mhechavarria/color-caps-classifier/programa motores/IMG_20181013_155259965.jpeg

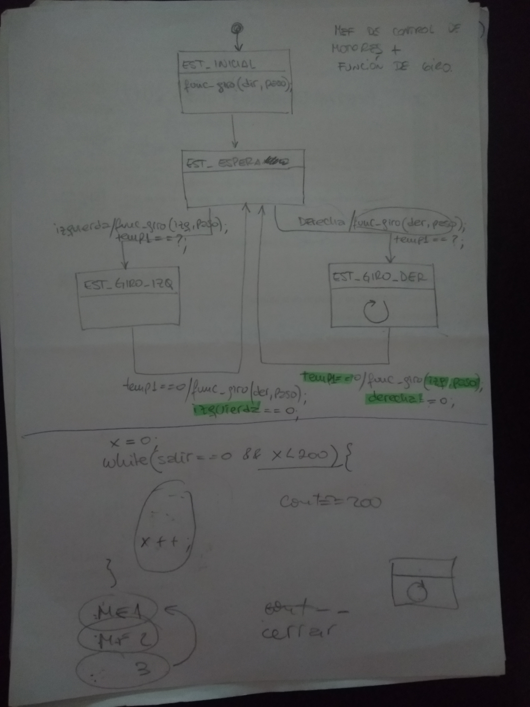
programa motores/IMG_20181013_155259965.jpeg
