mhechavarria/color-caps-classifier/Script/tapa_roja(1).png

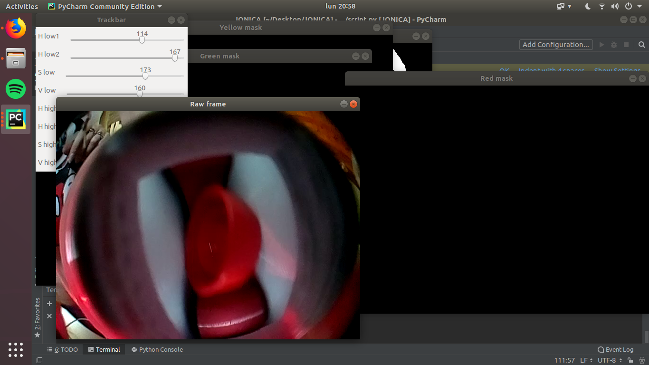
Script/tapa_roja(1).png
