mhechavarria/color-caps-classifier/README.md

# color-caps-classifier
A project made mostly in python to classifie color caps using OpenCV and Python

Link to video: https://drive.google.com/open?id=1r29vyWqCW7NpwiLaEyCusYoAQh5E9Sr1
