mhechavarria/color-caps-classifier/INFORME/mef_control_motores.png

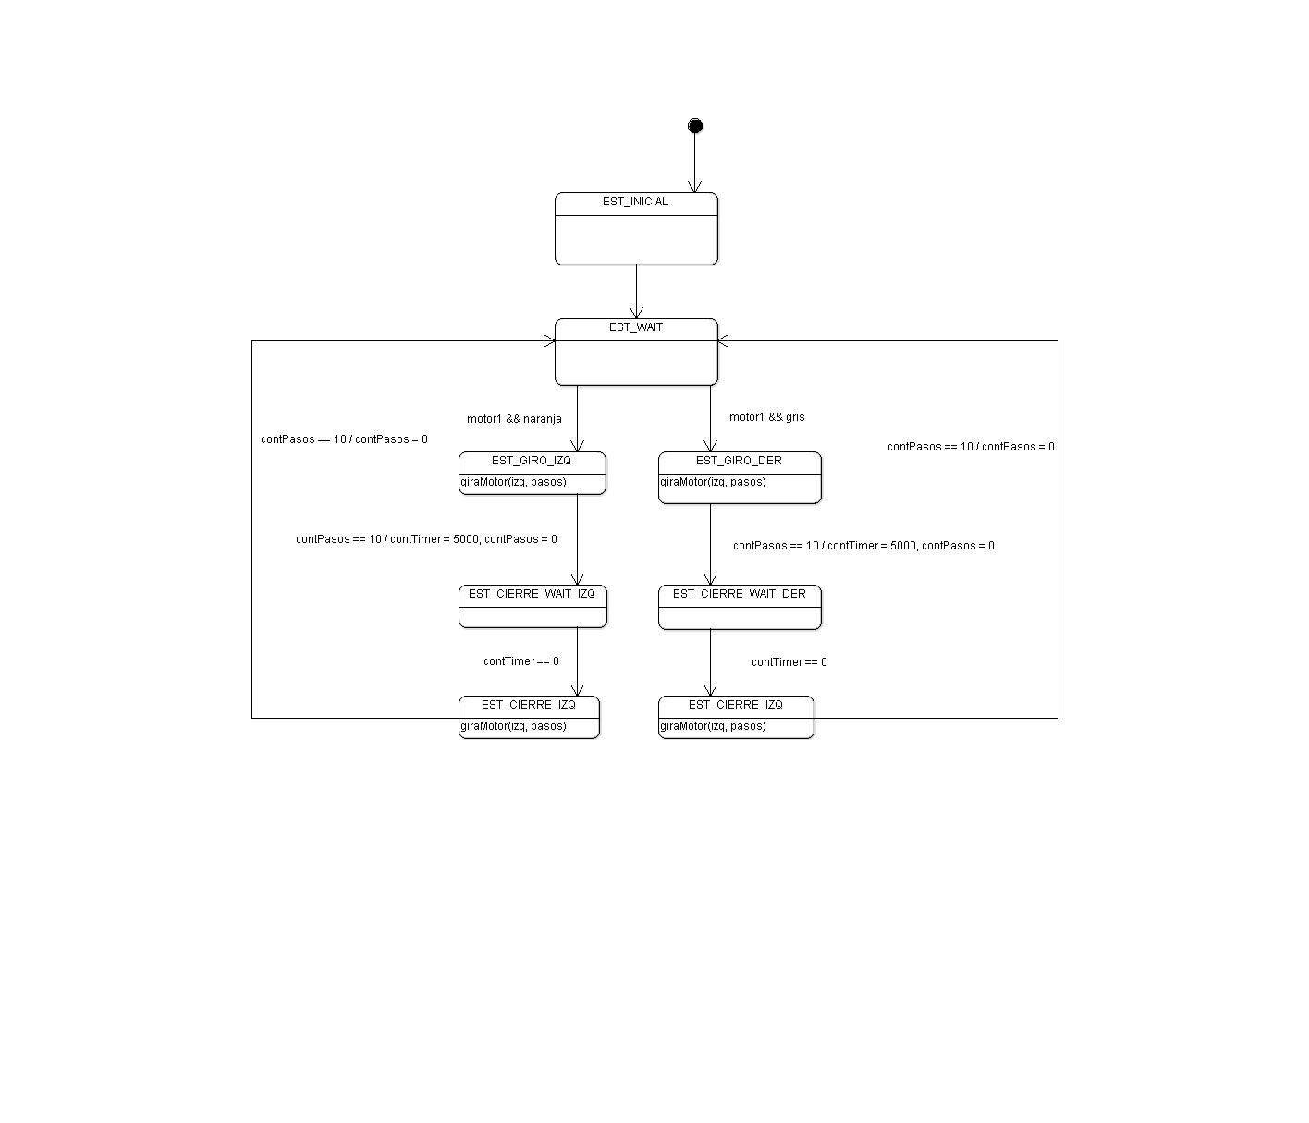
INFORME/mef_control_motores.png
