mhechavarria/color-caps-classifier/JONICA Rasp/Desktop/imagen2.jpg

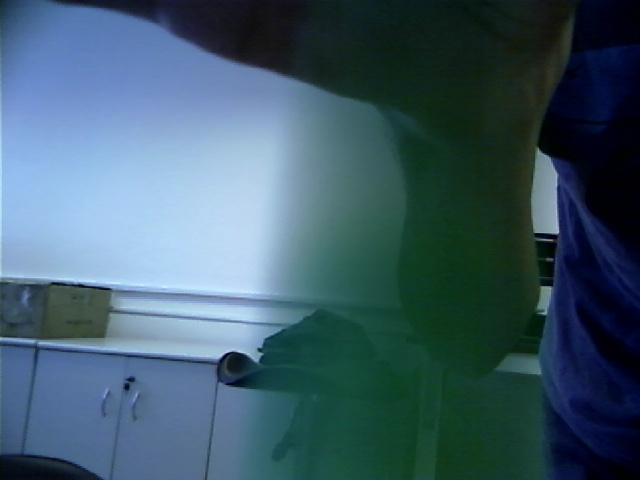
JONICA Rasp/Desktop/imagen2.jpg
