mhechavarria/color-caps-classifier/JONICA Rasp/WhatsApp Image 2019-03-05 at 5.52.41 PM.jpeg

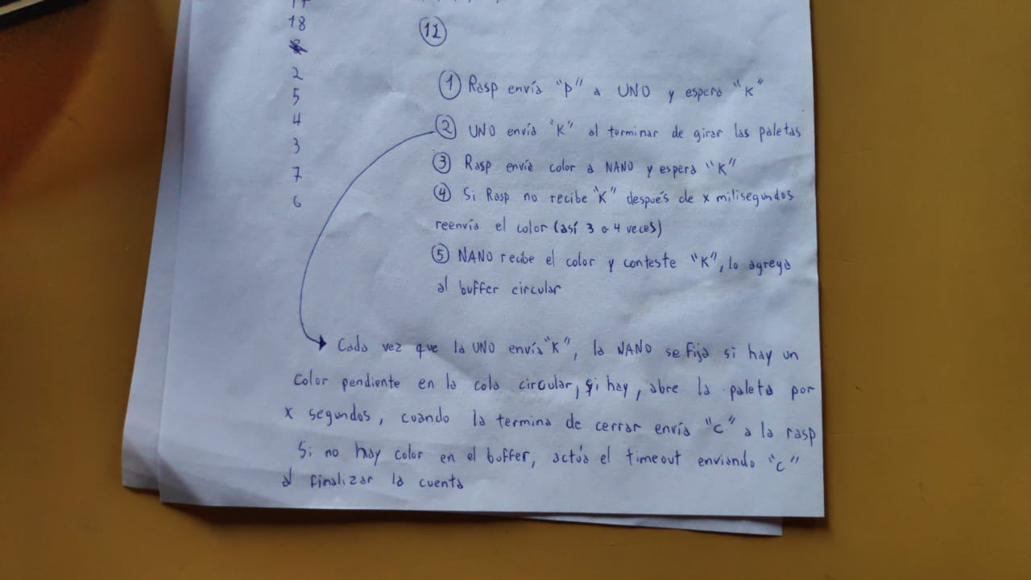
JONICA Rasp/WhatsApp Image 2019-03-05 at 5.52.41 PM.jpeg
