mhechavarria/color-caps-classifier/Modelos v4/Tuercas metrica.jpg

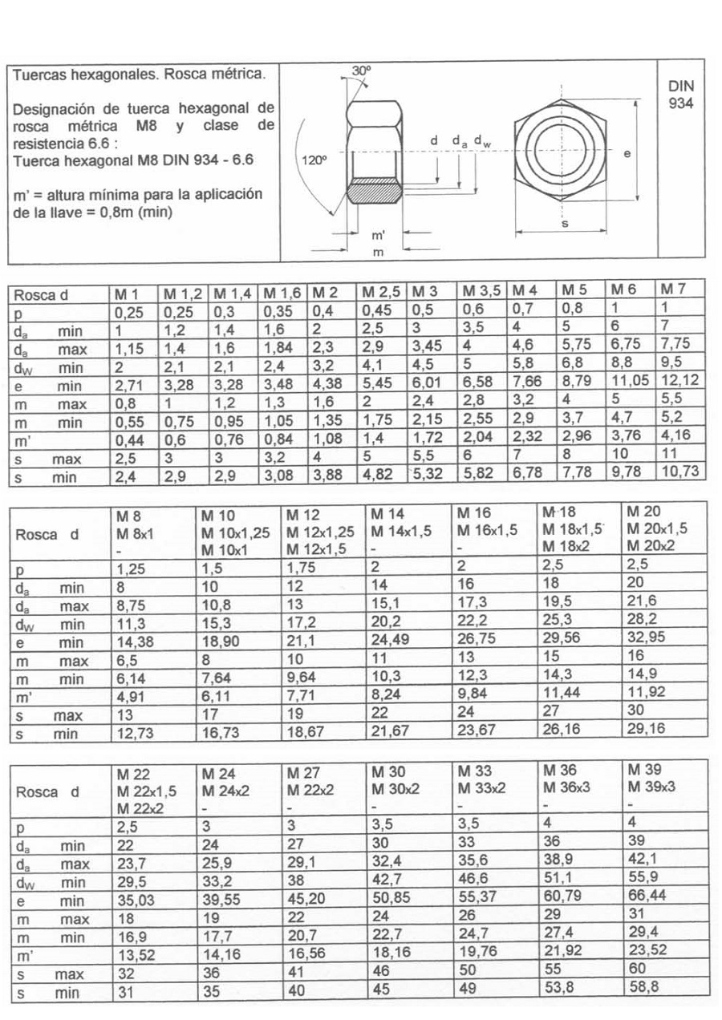
Modelos v4/Tuercas metrica.jpg
