mhechavarria/color-caps-classifier/Motor_paso_a_paso.ino/NEMA 17 sizes.png

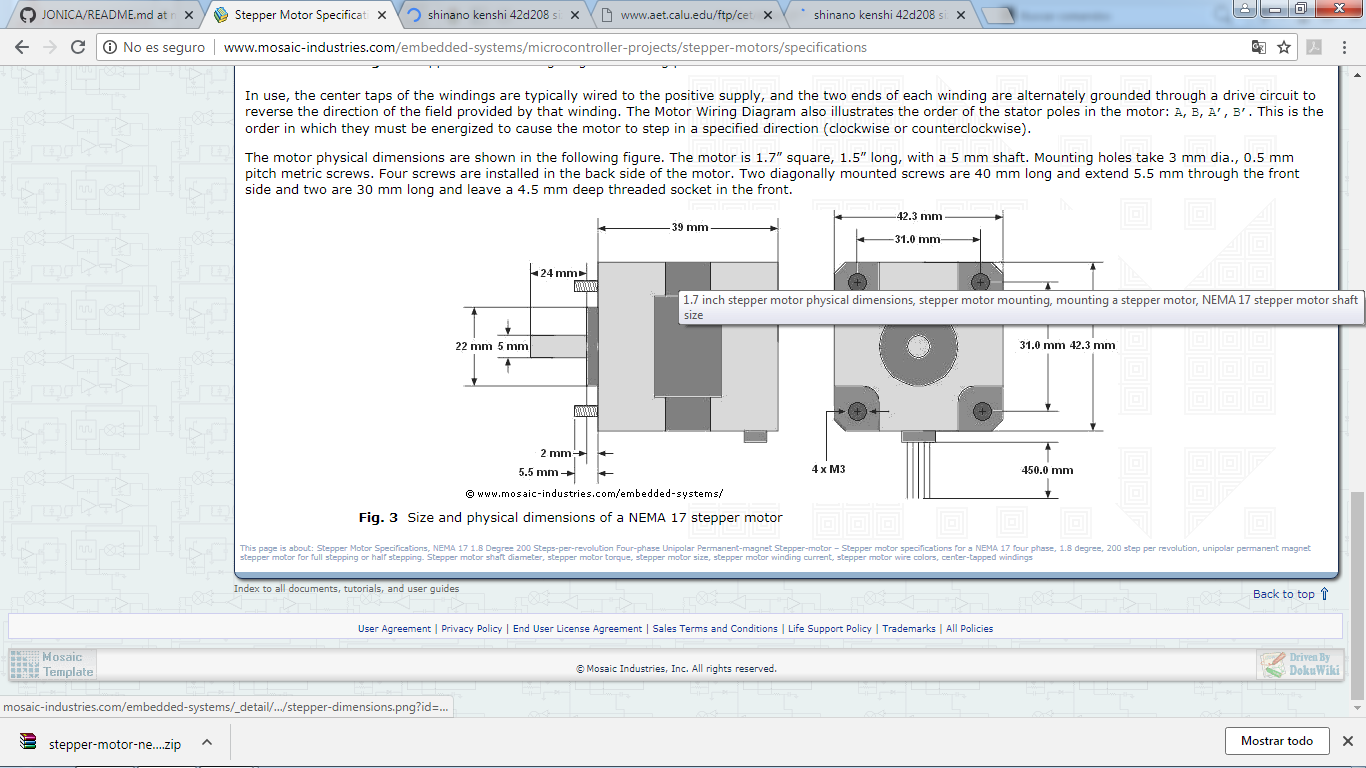
Motor_paso_a_paso.ino/NEMA 17 sizes.png
