mhechavarria/color-caps-classifier/programa motores/IMG_20181013_155317110.jpeg

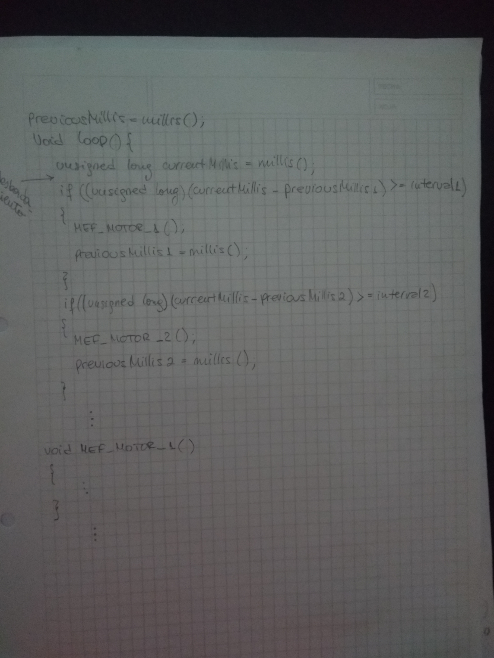
programa motores/IMG_20181013_155317110.jpeg
