mhechavarria/color-caps-classifier/programa motores/IMG_20181013_155327888.jpeg

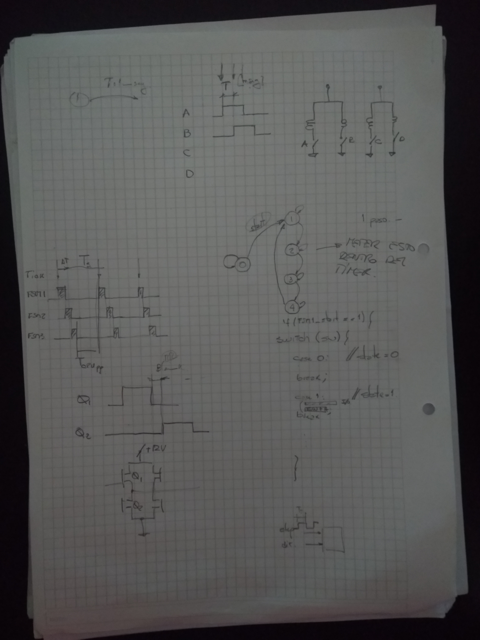
programa motores/IMG_20181013_155327888.jpeg
