mhechavarria/color-caps-classifier/programa motores/IMG_20181013_155341643.jpeg

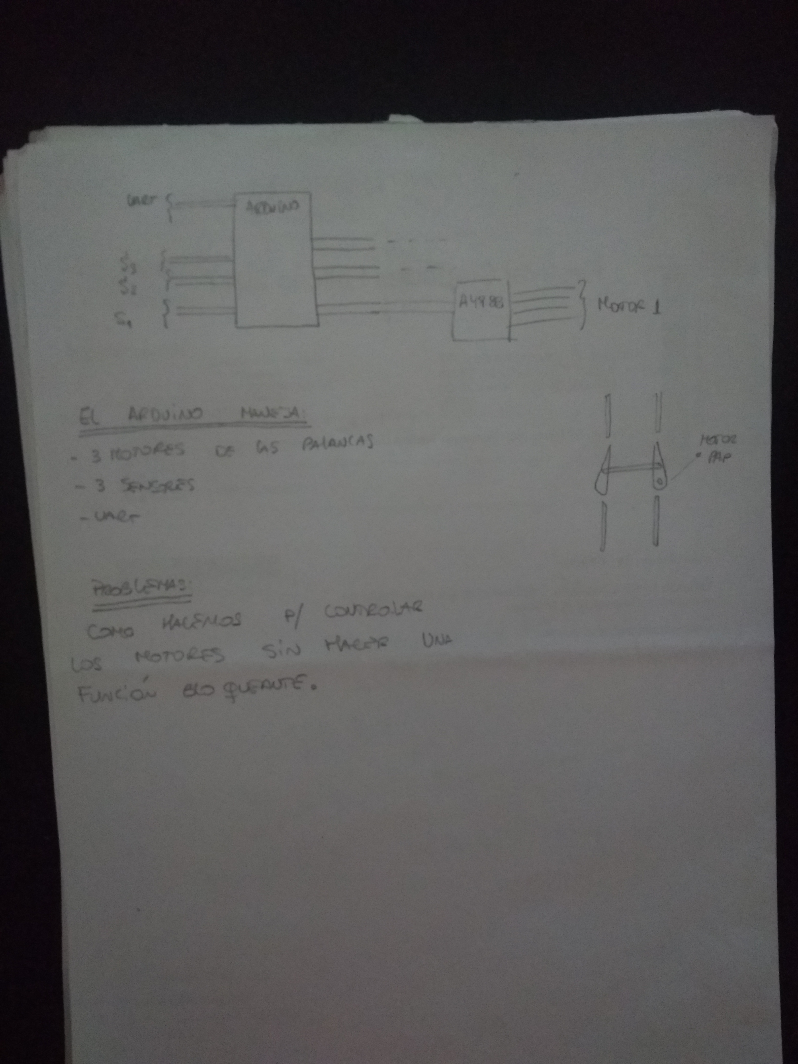
programa motores/IMG_20181013_155341643.jpeg
