mhechavarria/color-caps-classifier/programa motores/IMG_20181013_155406590.jpeg

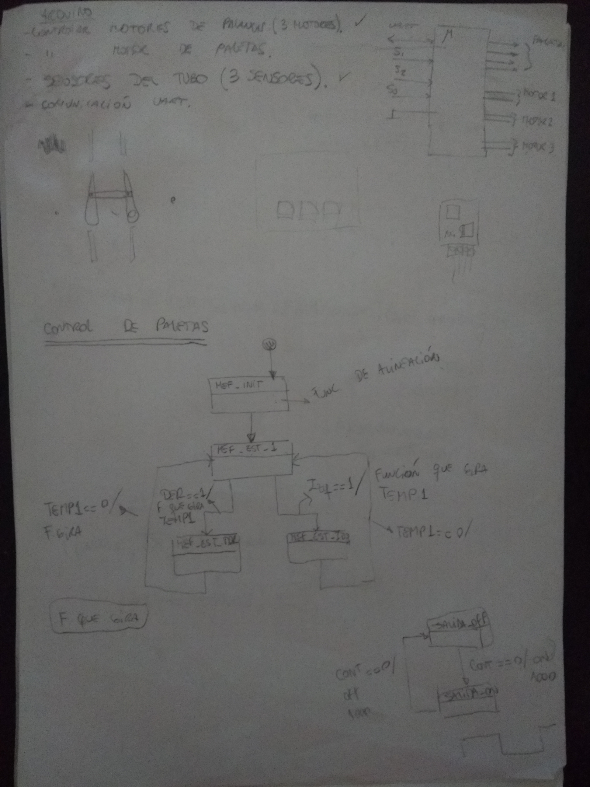
programa motores/IMG_20181013_155406590.jpeg
