mhechavarria/color-caps-classifier/programa motores/IMG_20181013_155413697.jpeg

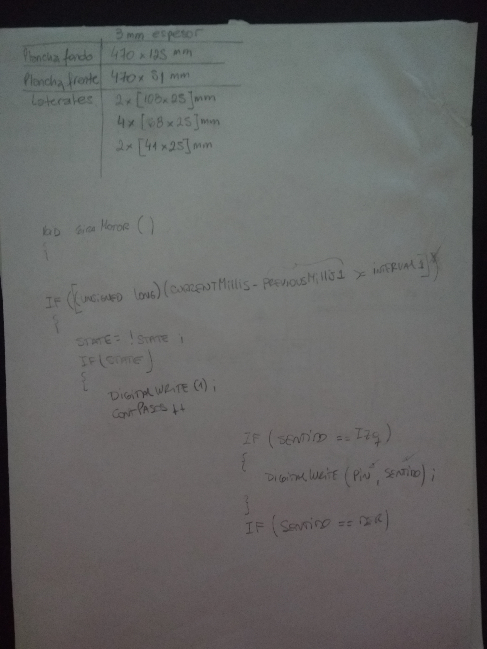
programa motores/IMG_20181013_155413697.jpeg
