mhechavarria/color-caps-classifier/programa motores/IMG_20190116_182555074.jpg

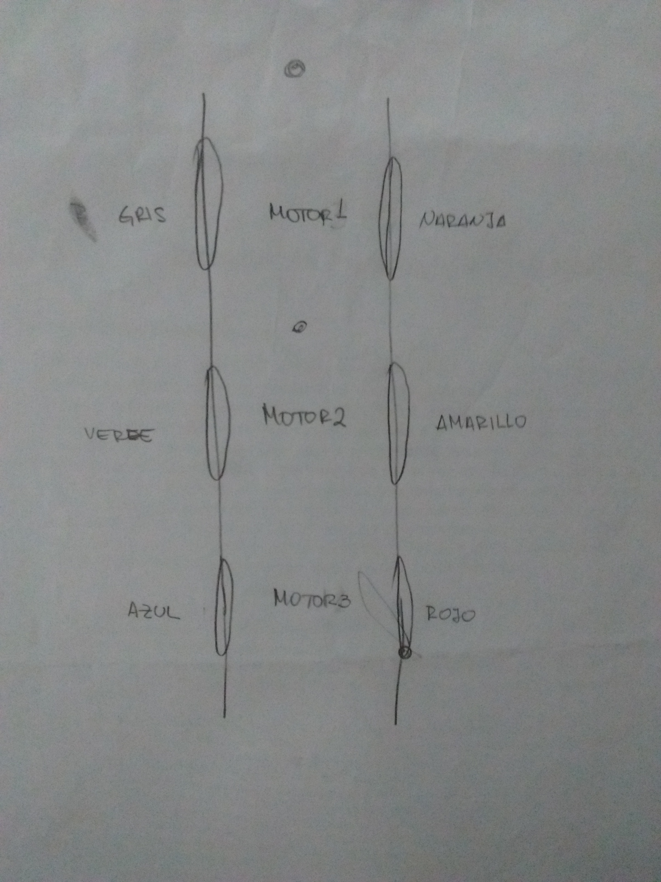
programa motores/IMG_20190116_182555074.jpg
