mhechavarria/color-caps-classifier/Script/tapa_verde(1).png

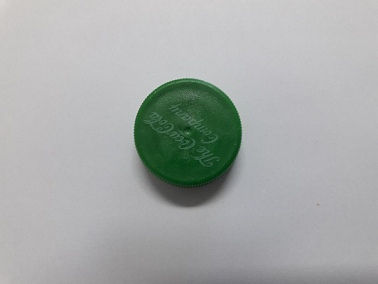
Script/tapa_verde(1).png
