mhechavarria/color-caps-classifier/Modelos v4/Ensamblaje.SLDASM

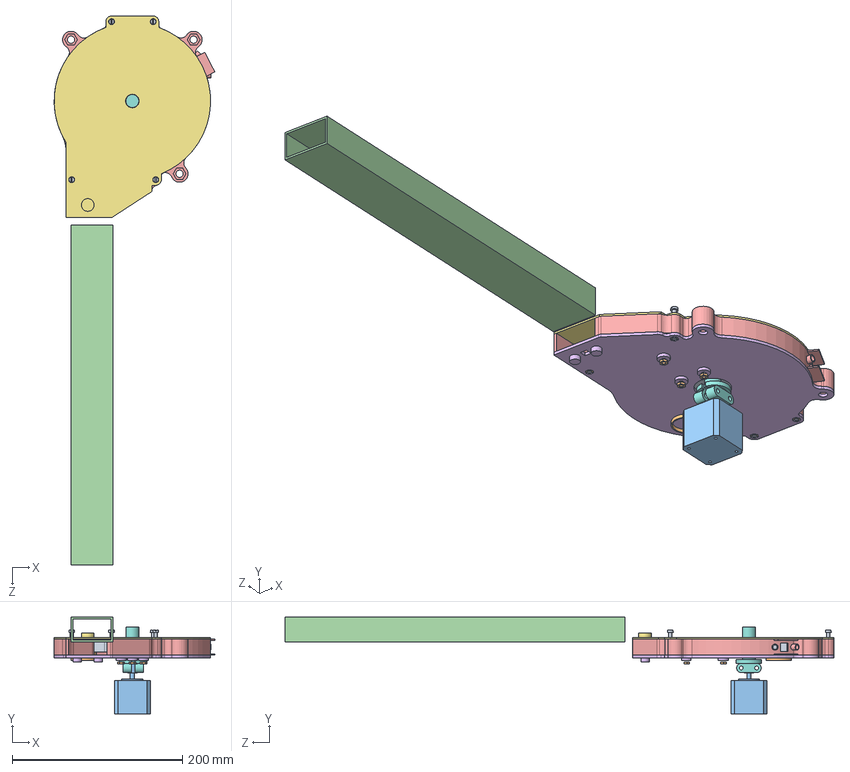
[picture p22: CAD file, 2019-12-16]
Modelos v4/Ensamblaje.SLDASM
189.0 x 113.8 x 645.7 mm
Prototipo
Tapa Coca Cola amarilla
Motor NEMA 17
Cargador
Curvas paletas
Tapa atras paletas
Tapa frente paletas
Acople NEMA 17 v2
slotted cheese head screw_din x 4
hex thin nut gradeb_din x 7
