mhechavarria/color-caps-classifier/Modelos v4/Palanquitas/Ensamblaje.SLDASM

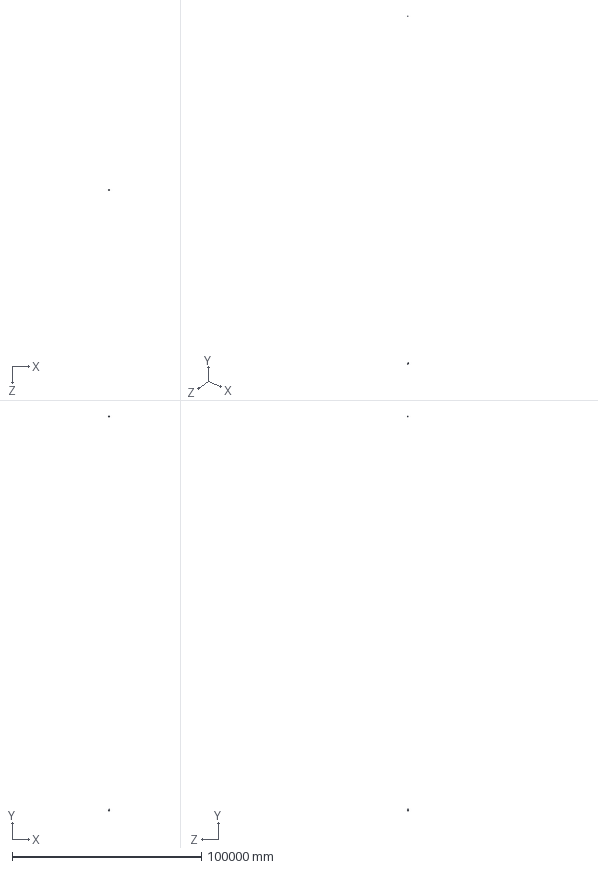
[picture p23: CAD file, 2019-12-16]
Modelos v4/Palanquitas/Ensamblaje.SLDASM
101.2 x 208279.6 x 134.6 mm
Palanquitas
SimetríaPalanquitas
Tapones x 2
