mhechavarria/color-caps-classifier/Modelos v4/Palanquitas/Tubo salida con palancas.SLDASM

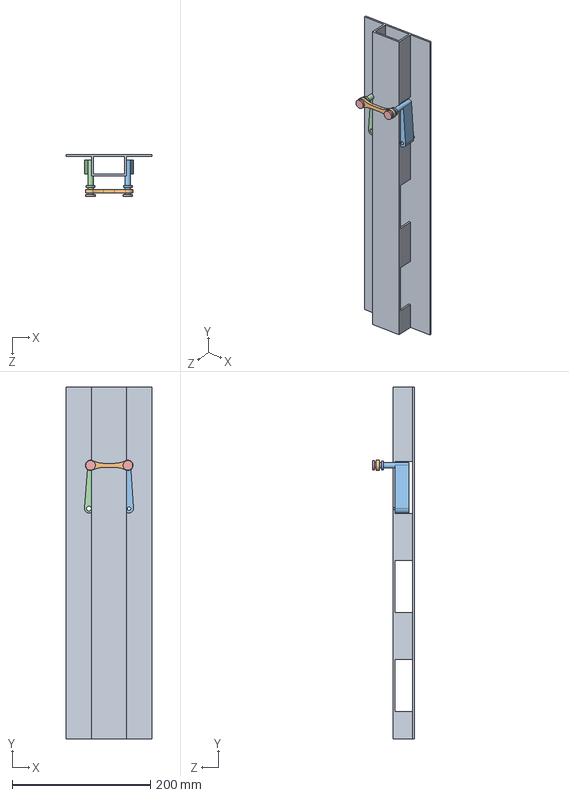
[picture p24: CAD file, 2019-12-16]
Modelos v4/Palanquitas/Tubo salida con palancas.SLDASM
125.0 x 509.0 x 61.0 mm
Tubo de salida
Palanquita der
Palanquita izq
Tapones x 2
