mhechavarria/color-caps-classifier/Modelos v4/Paredes paletas.SLDASM

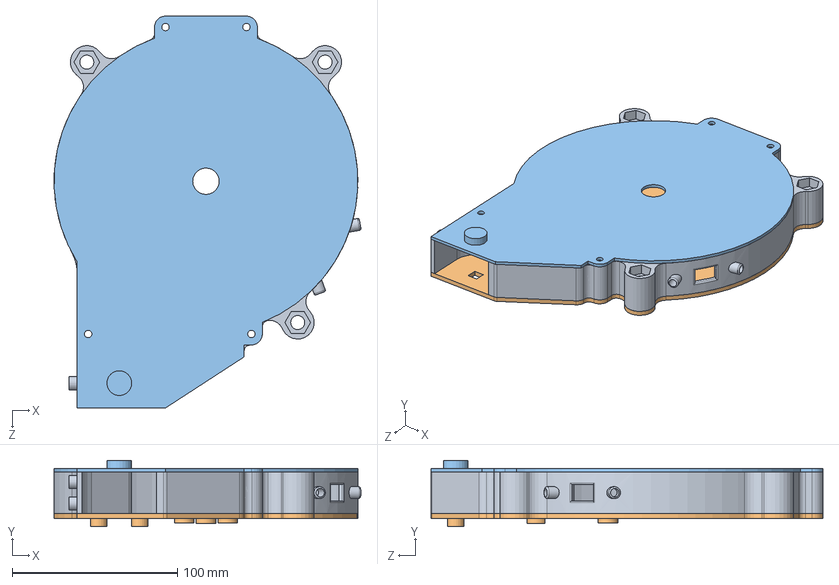
[picture p25: CAD file, 2019-12-16]
Modelos v4/Paredes paletas.SLDASM
185.9 x 40.0 x 237.2 mm
Curvas paletas
Tapa atras paletas
Tapa frente paletas
