mhechavarria/color-caps-classifier/Caño para seleccionar tapas/Palanquita2.SLDPRT

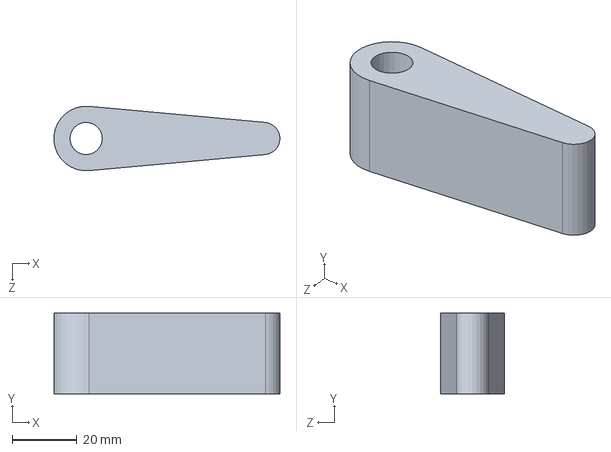
[picture p26: CAD file, 2019-12-16]
Caño para seleccionar tapas/Palanquita2.SLDPRT
70.0 x 25.0 x 19.9 mm
