mhechavarria/color-caps-classifier/Modelos v4/Case Raspberry/Base.SLDPRT

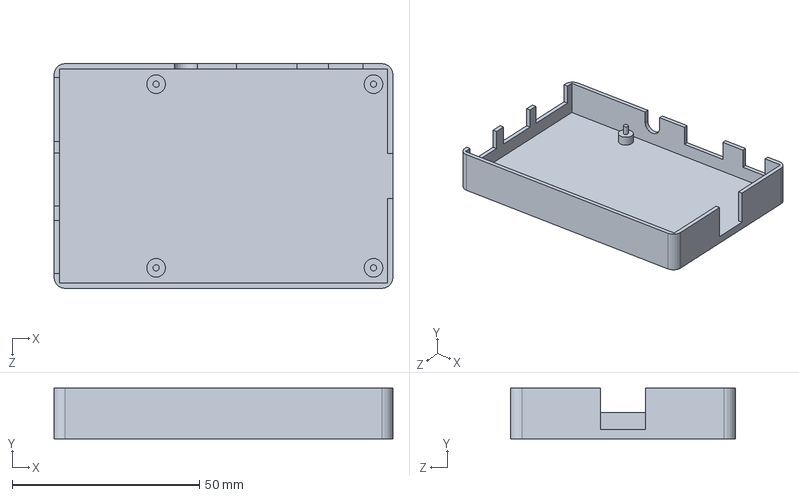
[picture p27: CAD file, 2019-12-16]
Modelos v4/Case Raspberry/Base.SLDPRT
90.4 x 13.6 x 60.0 mm
