mhechavarria/color-caps-classifier/Modelos v4/Palanquitas/Tapones.SLDPRT

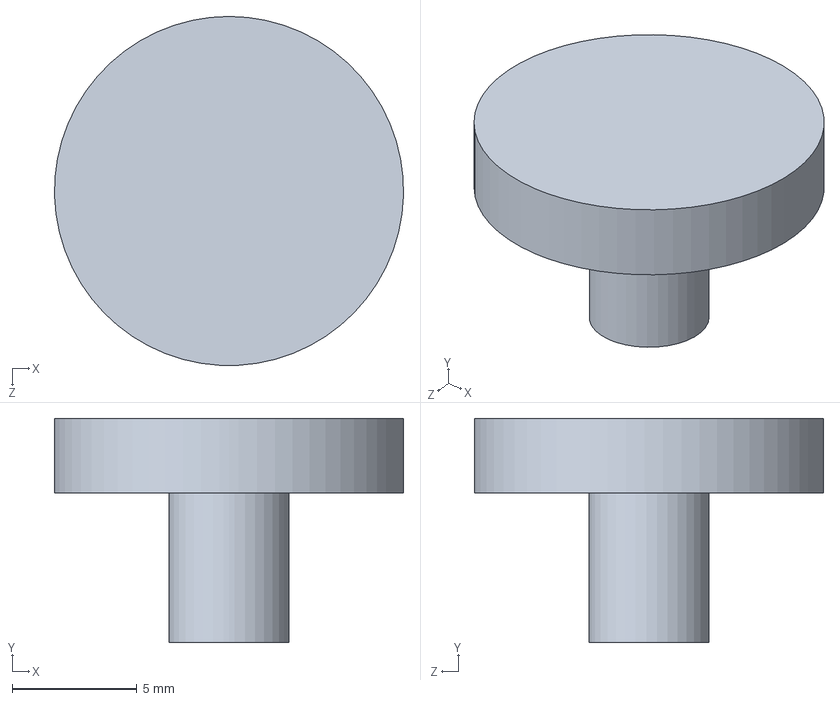
[picture p28: CAD file, 2019-12-16]
Modelos v4/Palanquitas/Tapones.SLDPRT
14.0 x 9.00 x 14.0 mm
