mhechavarria/color-caps-classifier/Modelos v4/Paredes paleta 1 (2).SLDPRT

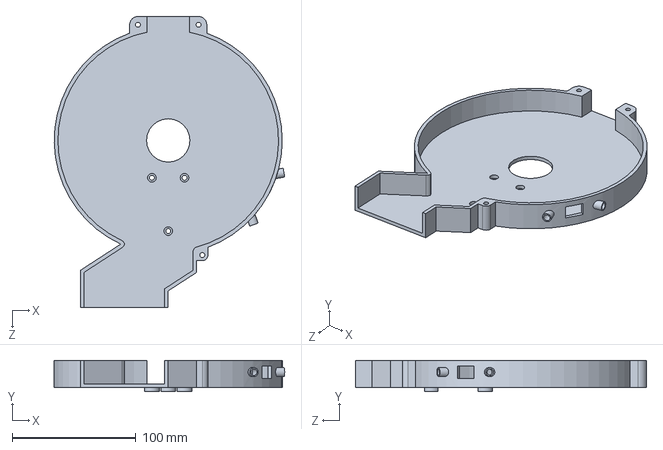
[picture p29: CAD file, 2019-12-16]
Modelos v4/Paredes paleta 1 (2).SLDPRT
186.0 x 25.3 x 234.8 mm
