mhechavarria/color-caps-classifier/Modelos v4/STL/Curvas paletas/Curva 1.STL

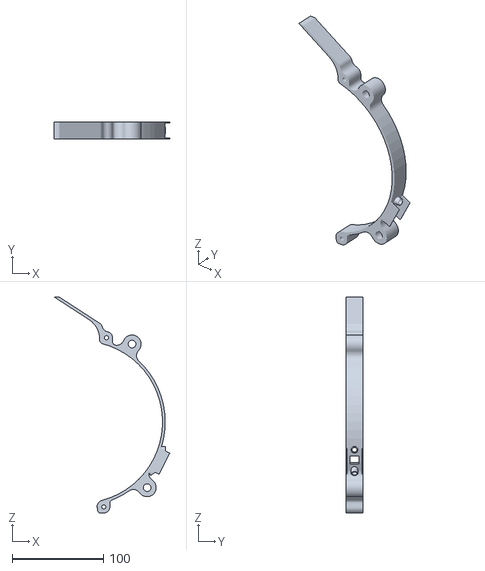
[picture p30: CAD file, 2019-12-16]
Modelos v4/STL/Curvas paletas/Curva 1.STL
127.0 x 19.0 x 237.2
