mhechavarria/color-caps-classifier/Caño para seleccionar tapas/Part1.SLDPRT

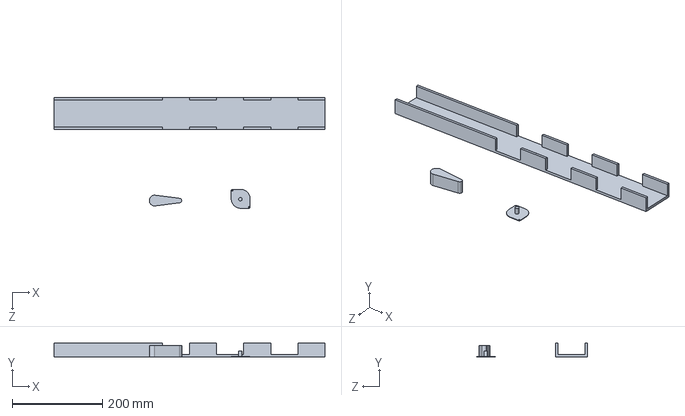
[picture p31: CAD file, 2019-12-16]
Caño para seleccionar tapas/Part1.SLDPRT
600.0 x 30.0 x 244.9 mm
