mhechavarria/color-caps-classifier/Modelos v4/Case Raspberry/Top.SLDPRT

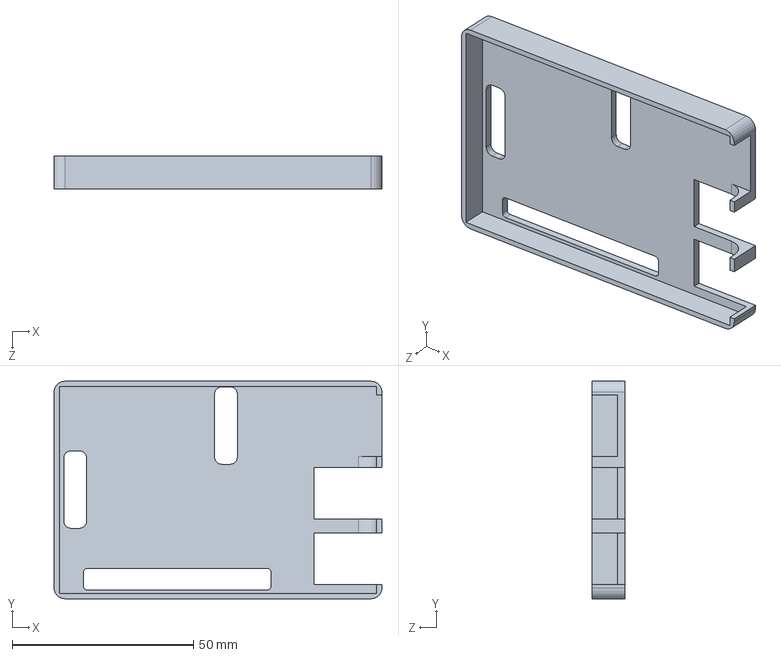
[picture p32: CAD file, 2019-12-16]
Modelos v4/Case Raspberry/Top.SLDPRT
90.4 x 60.0 x 9.00 mm
