mhechavarria/color-caps-classifier/Modelos v4/Motor NEMA 17.SLDPRT

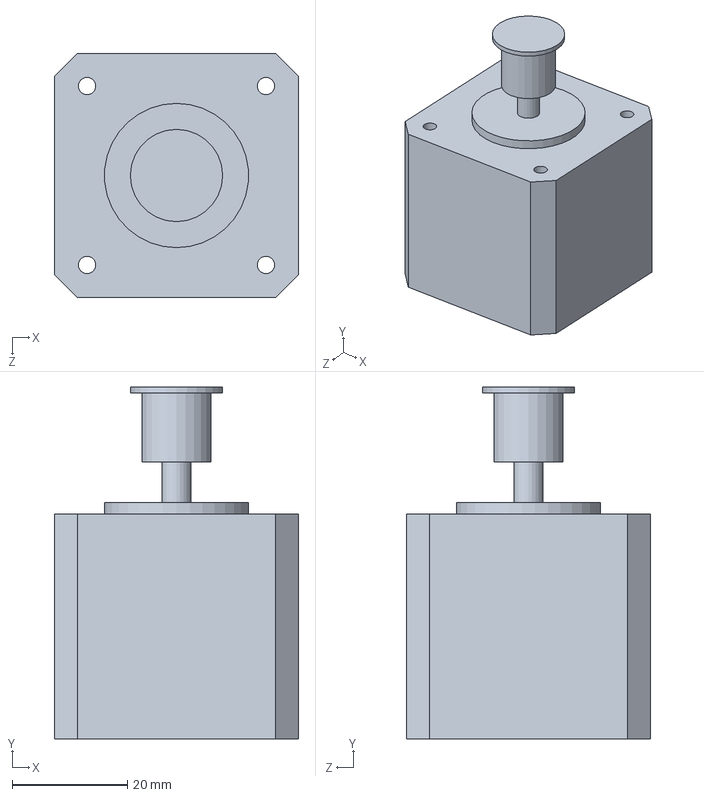
[picture p33: CAD file, 2019-12-16]
Modelos v4/Motor NEMA 17.SLDPRT
42.3 x 61.0 x 42.3 mm
