mhechavarria/color-caps-classifier/Modelos v4/STL/Curvas paletas/Curva 2.STL

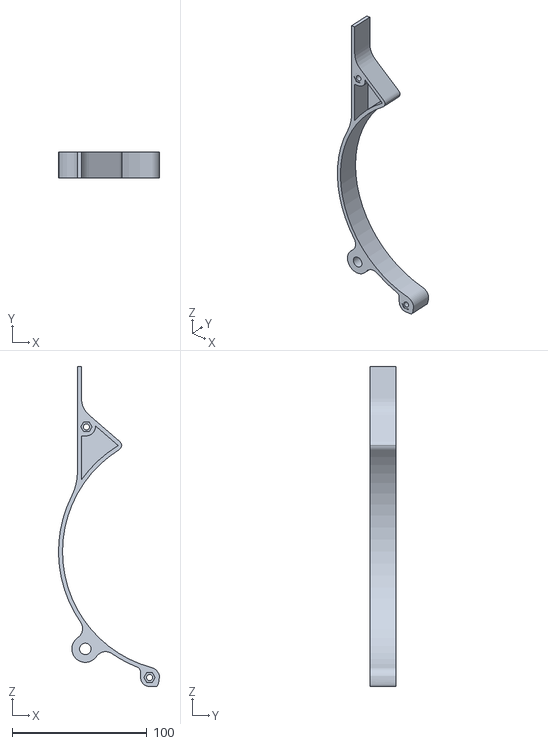
[picture p34: CAD file, 2019-12-16]
Modelos v4/STL/Curvas paletas/Curva 2.STL
74.8 x 19.0 x 237.2
