mhechavarria/color-caps-classifier/Caño para seleccionar tapas/Caño selector.SLDPRT

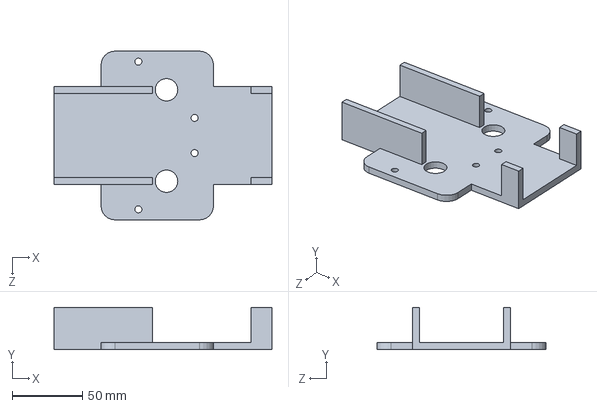
[picture p35: CAD file, 2019-12-16]
Caño para seleccionar tapas/Caño selector.SLDPRT
155.0 x 30.0 x 120.0 mm
