mhechavarria/color-caps-classifier/Modelos v4/Palanquitas/Palanquitas.SLDPRT

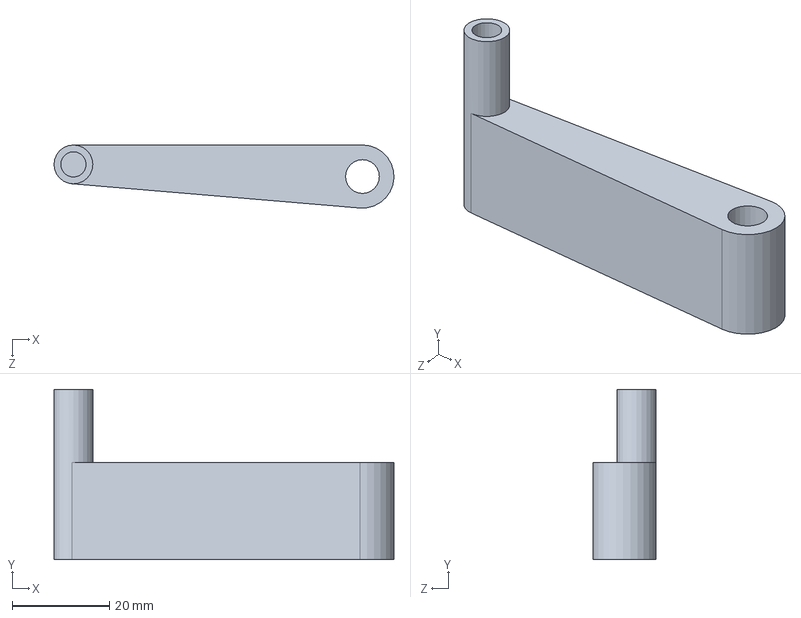
[picture p36: CAD file, 2019-12-16]
Modelos v4/Palanquitas/Palanquitas.SLDPRT
70.0 x 35.0 x 13.0 mm
