mhechavarria/color-caps-classifier/Modelos v4/Prototipo.SLDPRT

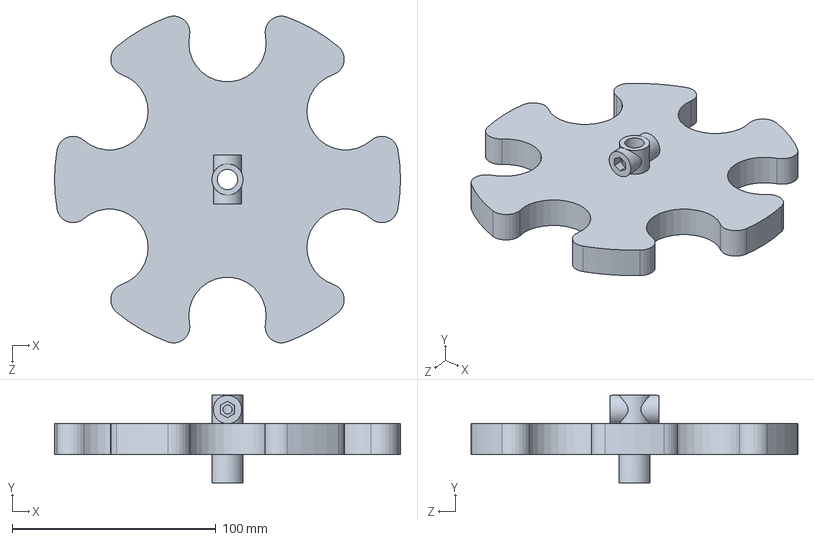
[picture p37: CAD file, 2019-12-16]
Modelos v4/Prototipo.SLDPRT
170.0 x 43.0 x 160.5 mm
