mhechavarria/color-caps-classifier/Modelos v4/Acople NEMA 17.SLDPRT

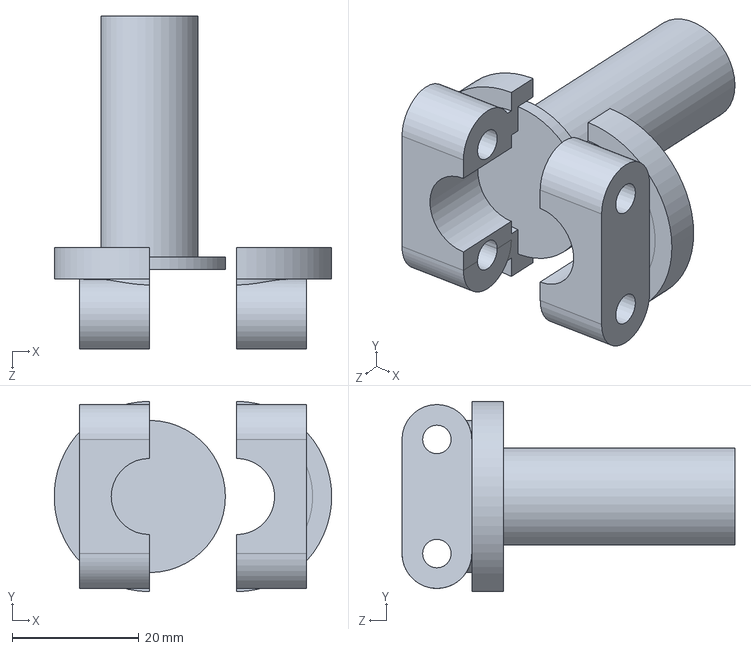
[picture p38: CAD file, 2019-12-16]
Modelos v4/Acople NEMA 17.SLDPRT
43.7 x 30.0 x 52.5 mm
