mhechavarria/color-caps-classifier/Modelos v4/Palanquitas/Perno.SLDPRT

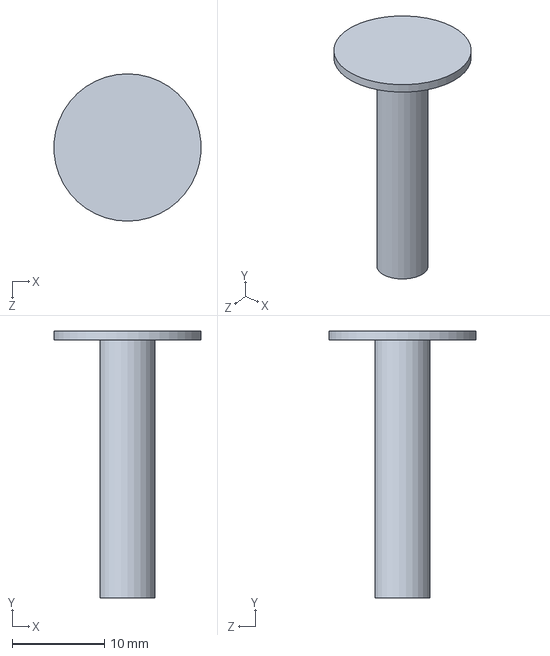
[picture p39: CAD file, 2019-12-16]
Modelos v4/Palanquitas/Perno.SLDPRT
16.0 x 29.0 x 16.0 mm
