mhechavarria/color-caps-classifier/Modelos v4/Tubo de salida.SLDPRT

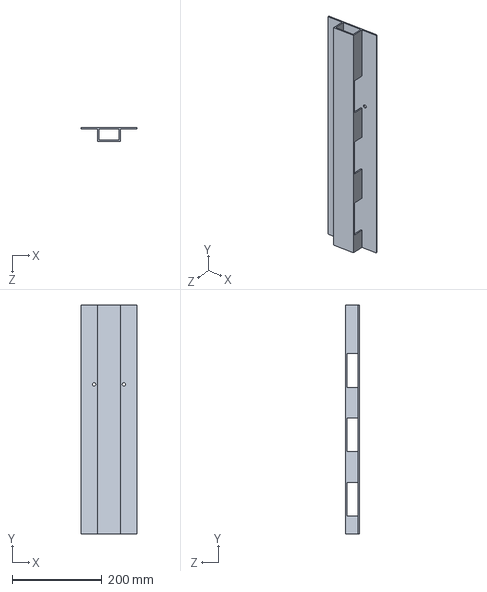
[picture p40: CAD file, 2019-12-16]
Modelos v4/Tubo de salida.SLDPRT
125.0 x 509.0 x 31.0 mm
