mhechavarria/color-caps-classifier/Modelos v4/Palanquitas/Union.SLDPRT

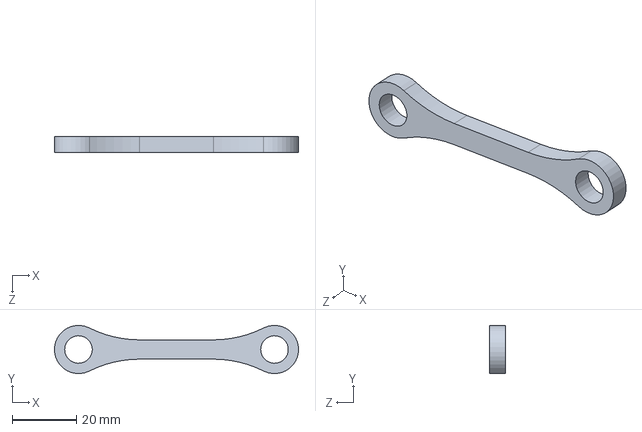
[picture p41: CAD file, 2019-12-16]
Modelos v4/Palanquitas/Union.SLDPRT
75.9 x 15.0 x 5.00 mm
