mhechavarria/color-caps-classifier/Modelos v4/Paredes Paleta.SLDPRT

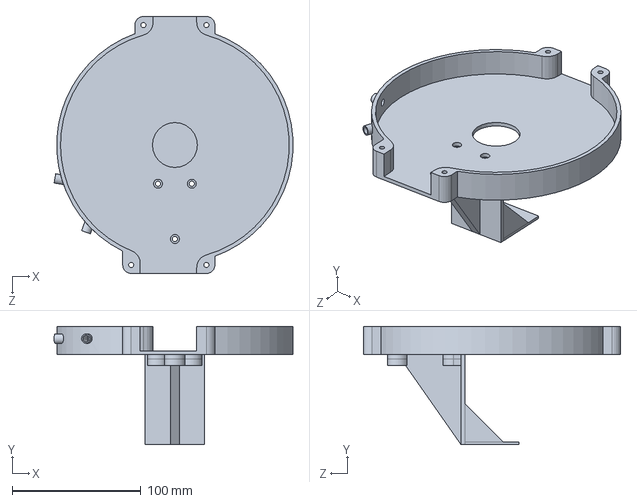
[picture p42: CAD file, 2019-12-16]
Modelos v4/Paredes Paleta.SLDPRT
185.9 x 92.0 x 200.0 mm
