mhechavarria/color-caps-classifier/Modelos v4/engranaje.SLDPRT

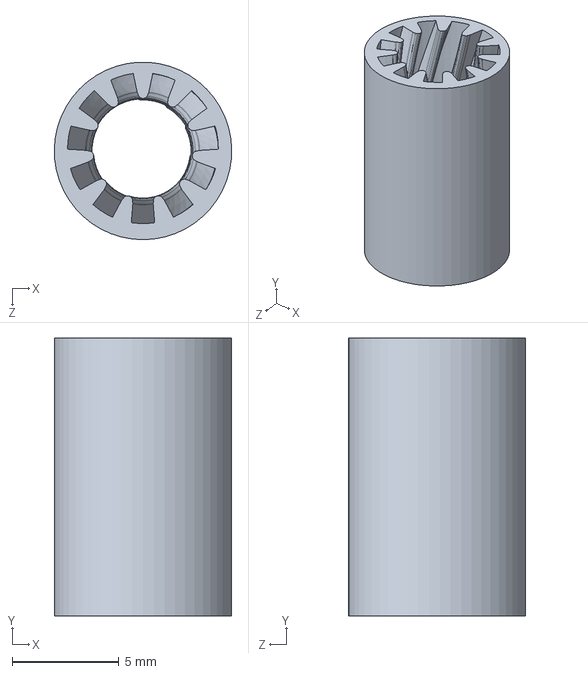
[picture p43: CAD file, 2019-12-16]
Modelos v4/engranaje.SLDPRT
8.30 x 13.0 x 8.29 mm
