mhechavarria/color-caps-classifier/Modelos v4/Palanquitas/Palanquita izq.SLDPRT

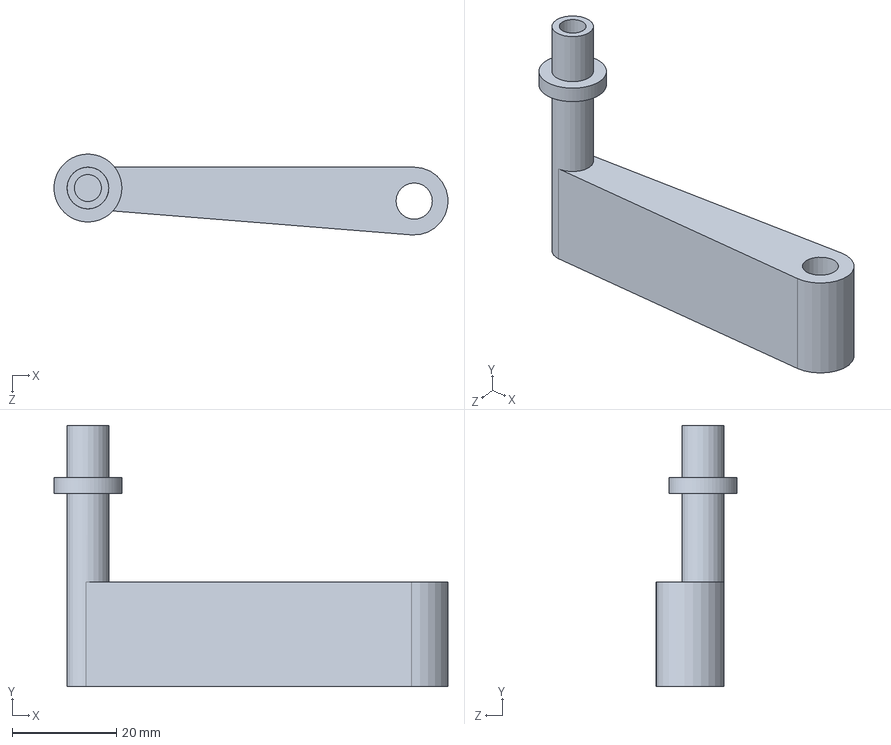
[picture p44: CAD file, 2019-12-16]
Modelos v4/Palanquitas/Palanquita izq.SLDPRT
75.5 x 50.0 x 15.5 mm
