mhechavarria/color-caps-classifier/Modelos v4/Palanquitas/Palanquita der.SLDPRT

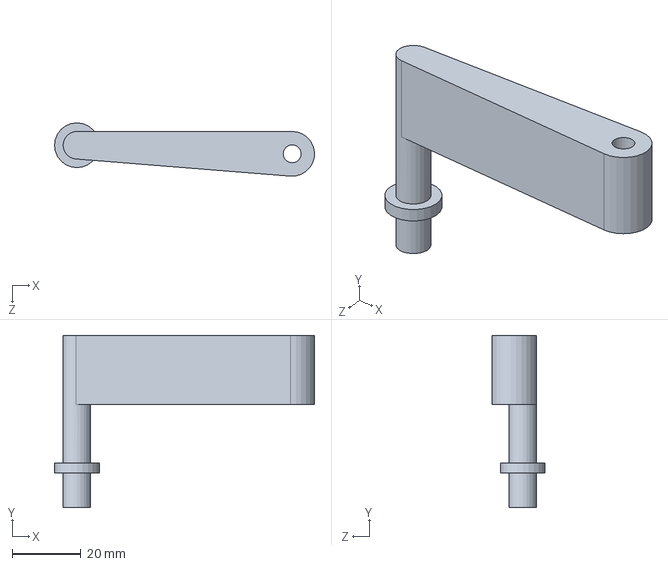
[picture p45: CAD file, 2019-12-16]
Modelos v4/Palanquitas/Palanquita der.SLDPRT
75.5 x 50.0 x 15.5 mm
