mhechavarria/color-caps-classifier/Modelos v4/Tapa frente paletas.SLDPRT

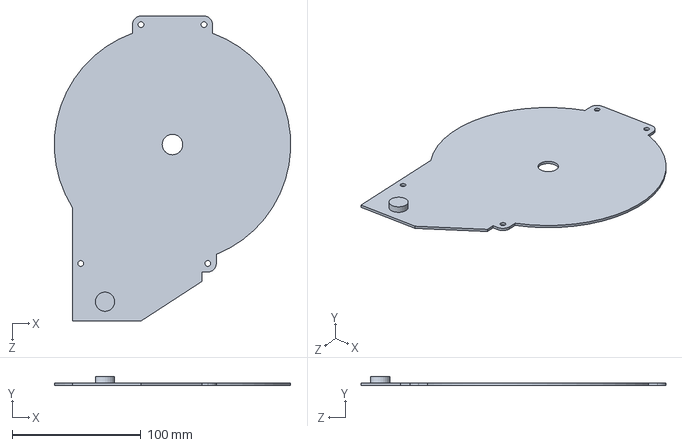
[picture p46: CAD file, 2019-12-16]
Modelos v4/Tapa frente paletas.SLDPRT
183.8 x 7.00 x 237.2 mm
