mhechavarria/color-caps-classifier/Modelos v4/Soporte paletas.SLDPRT

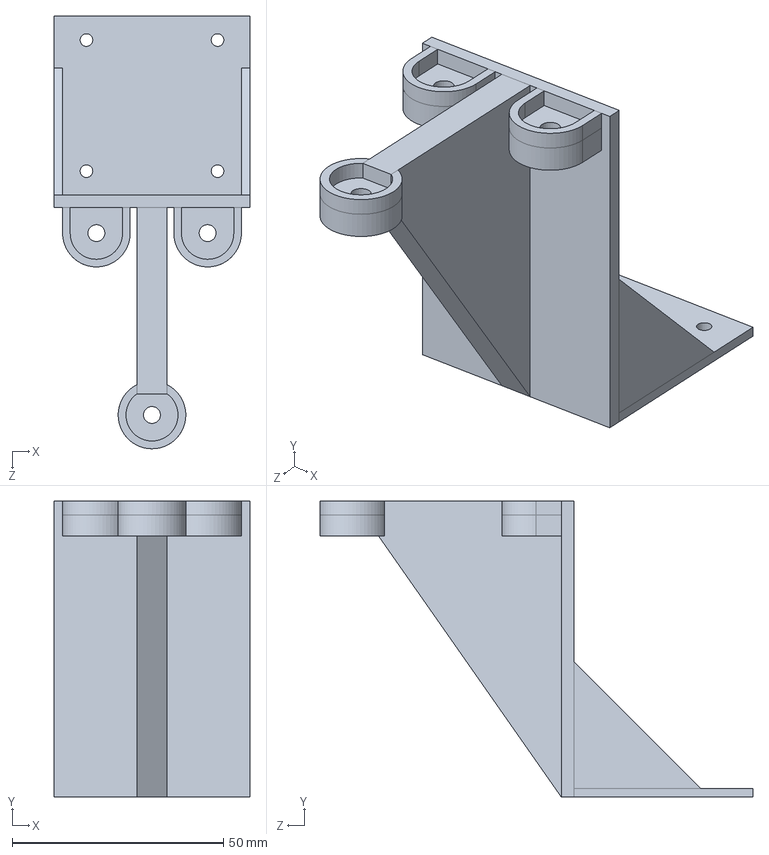
[picture p47: CAD file, 2019-12-16]
Modelos v4/Soporte paletas.SLDPRT
46.3 x 70.0 x 102.3 mm
