mhechavarria/color-caps-classifier/Modelos v4/Tapa atras paletas.SLDPRT

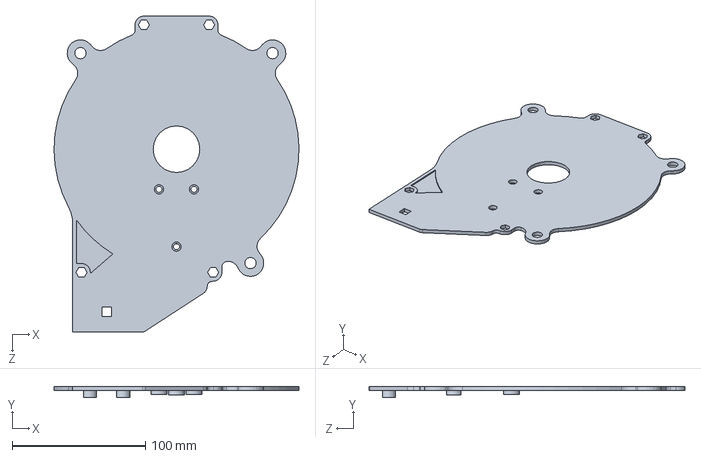
[picture p48: CAD file, 2019-12-16]
Modelos v4/Tapa atras paletas.SLDPRT
184.0 x 8.00 x 237.2 mm
