mhechavarria/color-caps-classifier/Modelos v4/Prueba encastre.SLDPRT

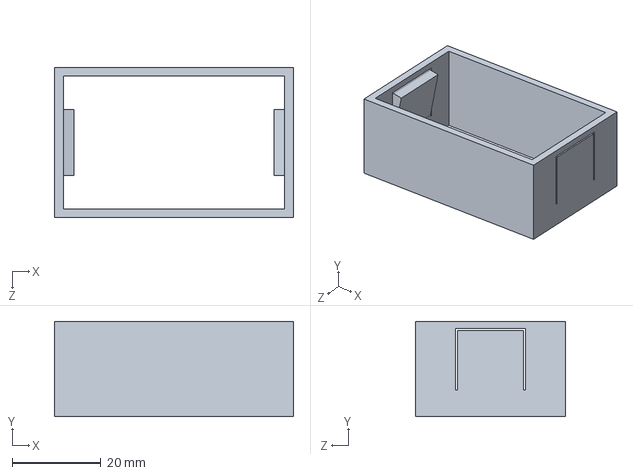
[picture p49: CAD file, 2019-12-16]
Modelos v4/Prueba encastre.SLDPRT
54.0 x 21.5 x 34.0 mm
