mhechavarria/color-caps-classifier/Modelos v4/Cargador.SLDPRT

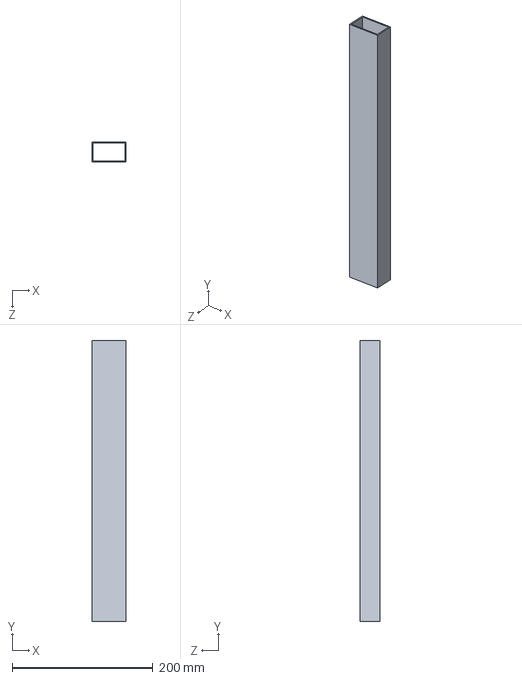
[picture p50: CAD file, 2019-12-16]
Modelos v4/Cargador.SLDPRT
49.0 x 400.0 x 29.0 mm
