mhechavarria/color-caps-classifier/Modelos v4/Tapa Coca Cola amarilla.SLDPRT

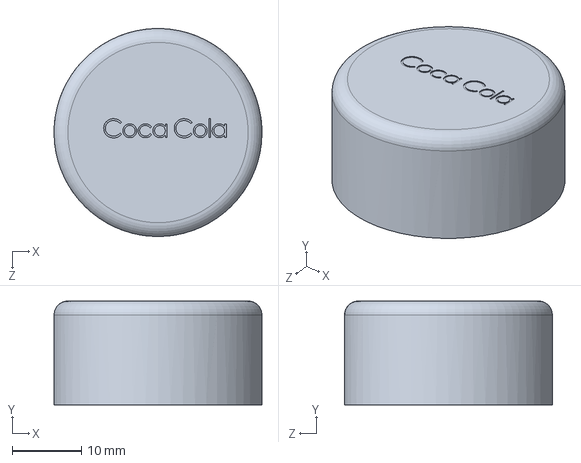
[picture p51: CAD file, 2019-12-16]
Modelos v4/Tapa Coca Cola amarilla.SLDPRT
30.0 x 15.0 x 30.0 mm
