mhechavarria/color-caps-classifier/Modelos v4/Curvas paletas.SLDPRT

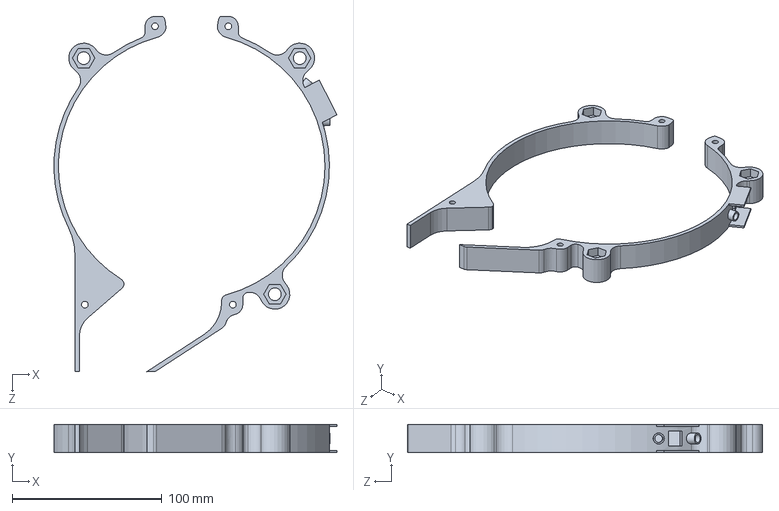
[picture p52: CAD file, 2019-12-16]
Modelos v4/Curvas paletas.SLDPRT
189.0 x 19.0 x 237.2 mm
