mhechavarria/color-caps-classifier/Modelos v4/Acople NEMA 17 v2.SLDPRT

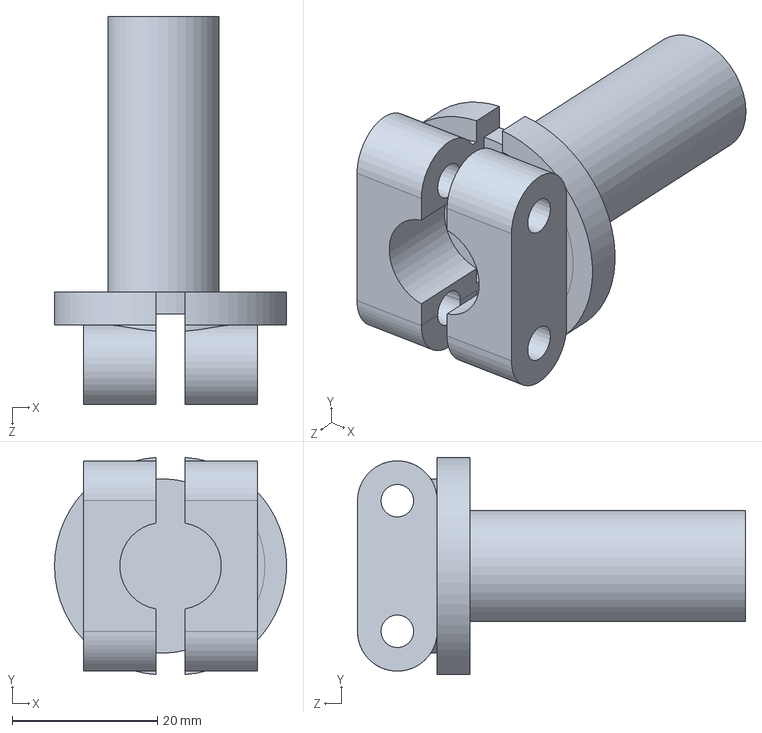
[picture p53: CAD file, 2019-12-16]
Modelos v4/Acople NEMA 17 v2.SLDPRT
32.0 x 29.9 x 53.5 mm
