mhechavarria/color-caps-classifier/Modelos v4/Prototipo - es el que fue impreso, ancho de 17mm.SLDPRT

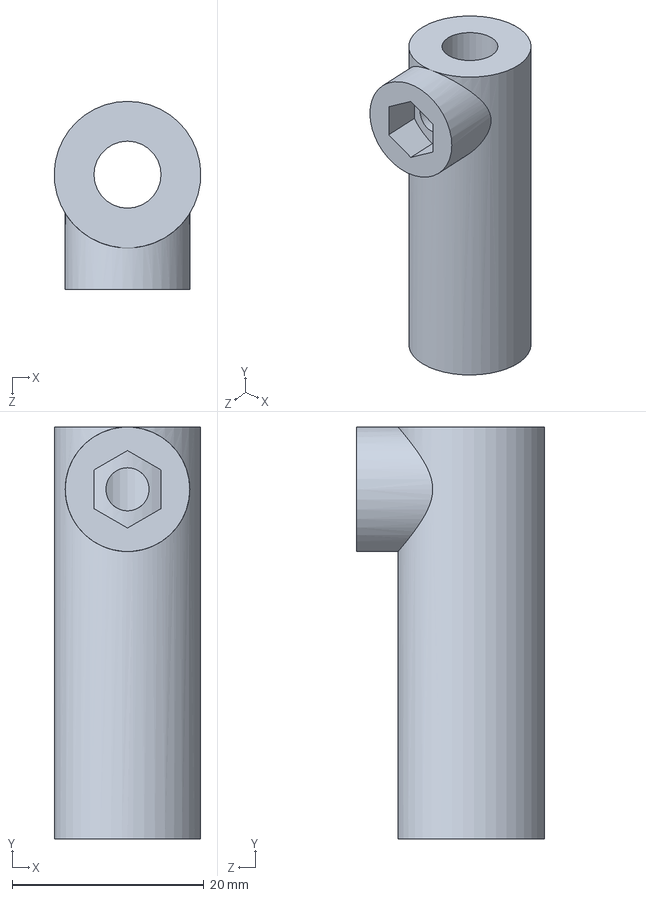
[picture p54: CAD file, 2019-12-16]
Modelos v4/Prototipo - es el que fue impreso, ancho de 17mm.SLDPRT
15.3 x 43.0 x 19.6 mm
