mhechavarria/color-caps-classifier/(list of files, cad)

Other CAD files:
Modelos v4/Palanquitas/SimetríaPalanquitas.SLDPRT
Caño para seleccionar tapas/Palanquita.SLDPRT
Modelos v4/Palanquitas/Palanquita der.STL
Modelos v4/Palanquitas/Palanquita izq.STL
Modelos v4/Palanquitas/Tapones.STL
Modelos v4/Palanquitas/Union.STL
Modelos v4/Paredes paleta tapa viejo.SLDPRT
Modelos v4/Prototipo.SLDDRW
Modelos v4/STL/Palanquitas/Palanquita der.STL
Modelos v4/STL/Palanquitas/Palanquita izq.STL
Modelos v4/STL/Palanquitas/Tapones.STL
Modelos v4/STL/Palanquitas/Union.STL
Modelos v4/backup/Paredes paleta 2.SLDPRT
Modelos v4/backup/Paredes paleta tapa.SLDPRT
Modelos v4/backup/Paredes paletas.SLDASM
