mhechavarria/color-caps-classifier/planos2.pdf

E E

F F

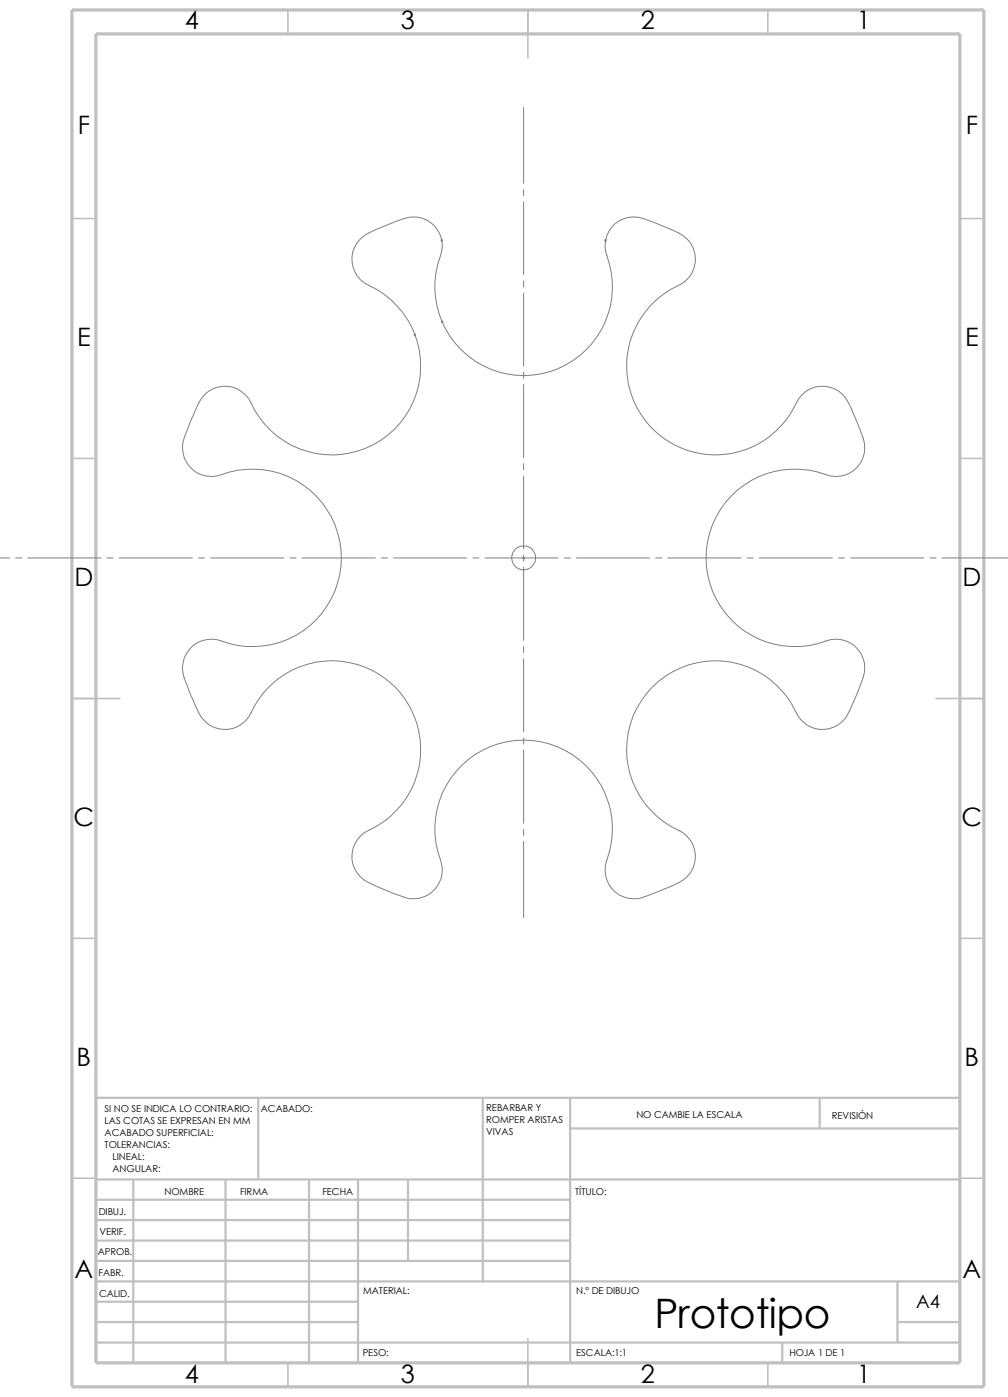
[picture p55: page 1]
REVISIÓN; N.º DE DIBUJO; ESCALA:1:1; HOJA 1 DE 1; PESO:; MATERIAL:; FABR.; CALID.; ACABADO:; VIVAS; REBARBAR Y ROMPER ARISTAS; Prototipo

SI NO SE INDICA LO CONTRARIO:
LAS COTAS SE EXPRESAN EN MM
ACABADO SUPERFICIAL:
TOLERANCIAS:
LINEAL:
ANGULAR:

NO CAMBIE LA ESCALA

NOMBRE | FIRMA | FECHA | TÍTULO:

DIBUJ.
VERIF.
APROB.
