mhechavarria/color-caps-classifier/Modelos v4/Prototipo.PDF

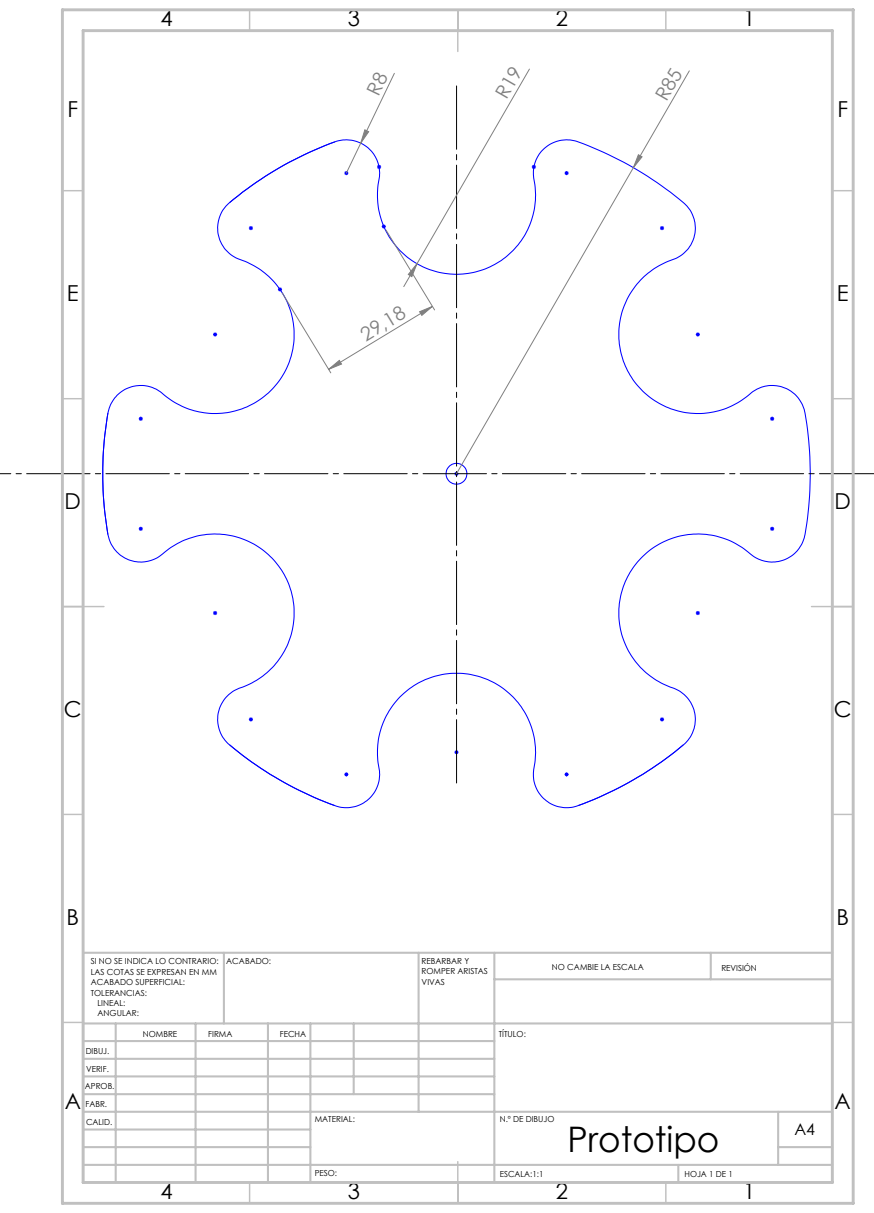
[picture p56: page 1]
ACABADO:; REBARBAR Y; ROMPER ARISTAS; NO CAMBIE LA ESCALA; REVISIÓN; ESCALA:1:1; HOJA 1 DE 1

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

NOMBRE | FIRMA | FECHA | | | | TÍTULO:

DIBUJ.
VERIF.
APROB.
FABR.
CALID. | | | | MATERIAL: | N.º DE DIBUJO Prototipo | A4
