mhechavarria/color-caps-classifier/Circuito/Shield/Gerber/JONICA-B.Cu.pdf

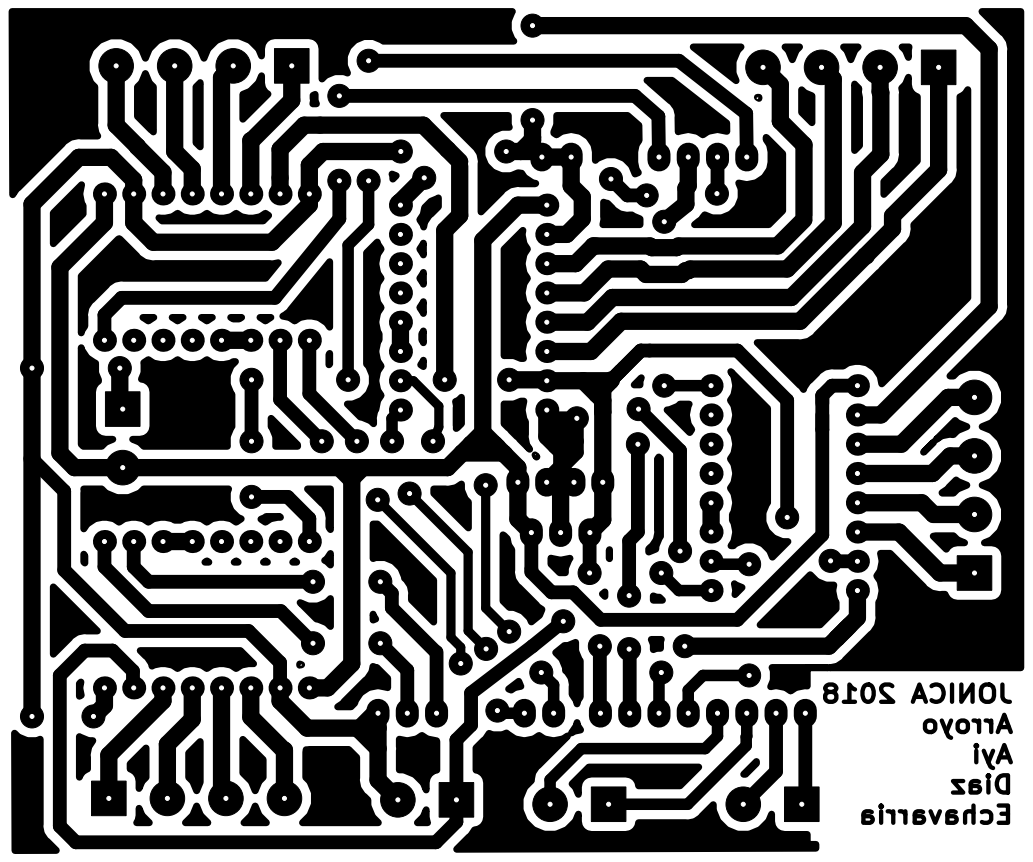
[picture p57: page 1]
