mhechavarria/color-caps-classifier/Circuito/Circuito v2/Circuito v2.kicad_pcb

## KiCad design Circuito/Circuito v2/Circuito v2.kicad_pcb (2019-12-16)

Schematic: Circuito v2.sch

Parts:
J1: SENSOR1; TerminalBlock_bornier-3_P5.08mm
R1: 220; R_Axial_DIN0207_L6.3mm_D2.5mm_P7.62mm_Horizontal
R2: 39K; R_Axial_DIN0207_L6.3mm_D2.5mm_P7.62mm_Horizontal
R3: 47K; R_Axial_DIN0207_L6.3mm_D2.5mm_P7.62mm_Horizontal
R4, R6: 10K; R_Axial_DIN0207_L6.3mm_D2.5mm_P7.62mm_Horizontal
R5: 1K6; R_Axial_DIN0207_L6.3mm_D2.5mm_P7.62mm_Horizontal
U1: CNY70; DIP-4_W7.62mm_LongPads
U2: LM324; DIP-14_W7.62mm_LongPads

Connections:
+5V: J1.1, R1.1, R3.1, U1.3, U2.4 (V+)
GND: J1.3, R2.1, R4.2, U1.2, U2.11 (V-)
unnamed: J1.2, R6.2, U2.7
unnamed: R1.2, U1.1
unnamed: R2.2, U1.4, U2.3 (+)
unnamed: R3.2, R4.1, U2.6 (-)
unnamed: R5.1, U2.1, U2.2 (-)
unnamed: R5.2, R6.1, U2.5 (+)

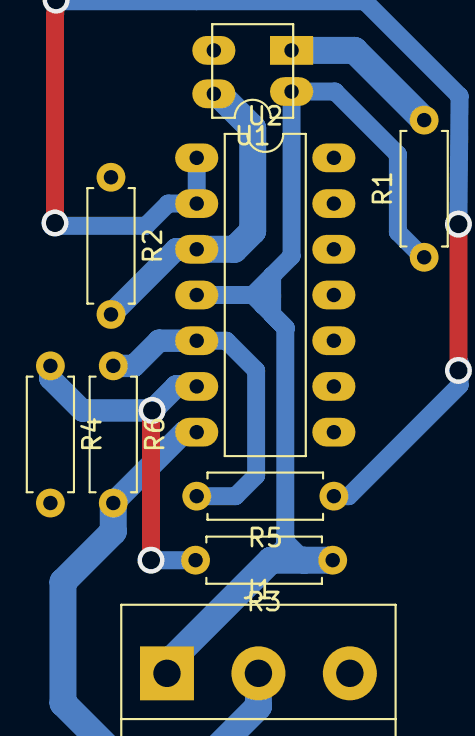
[picture p58: board Circuito v2.kicad_pcb from above]

Board: 2 copper layers, 9 parts (0 on the bottom side), 8 nets.
