mhechavarria/color-caps-classifier/Circuito/Shield/JONICA.kicad_pcb

## KiCad design Circuito/Shield/JONICA.kicad_pcb (2019-12-16)

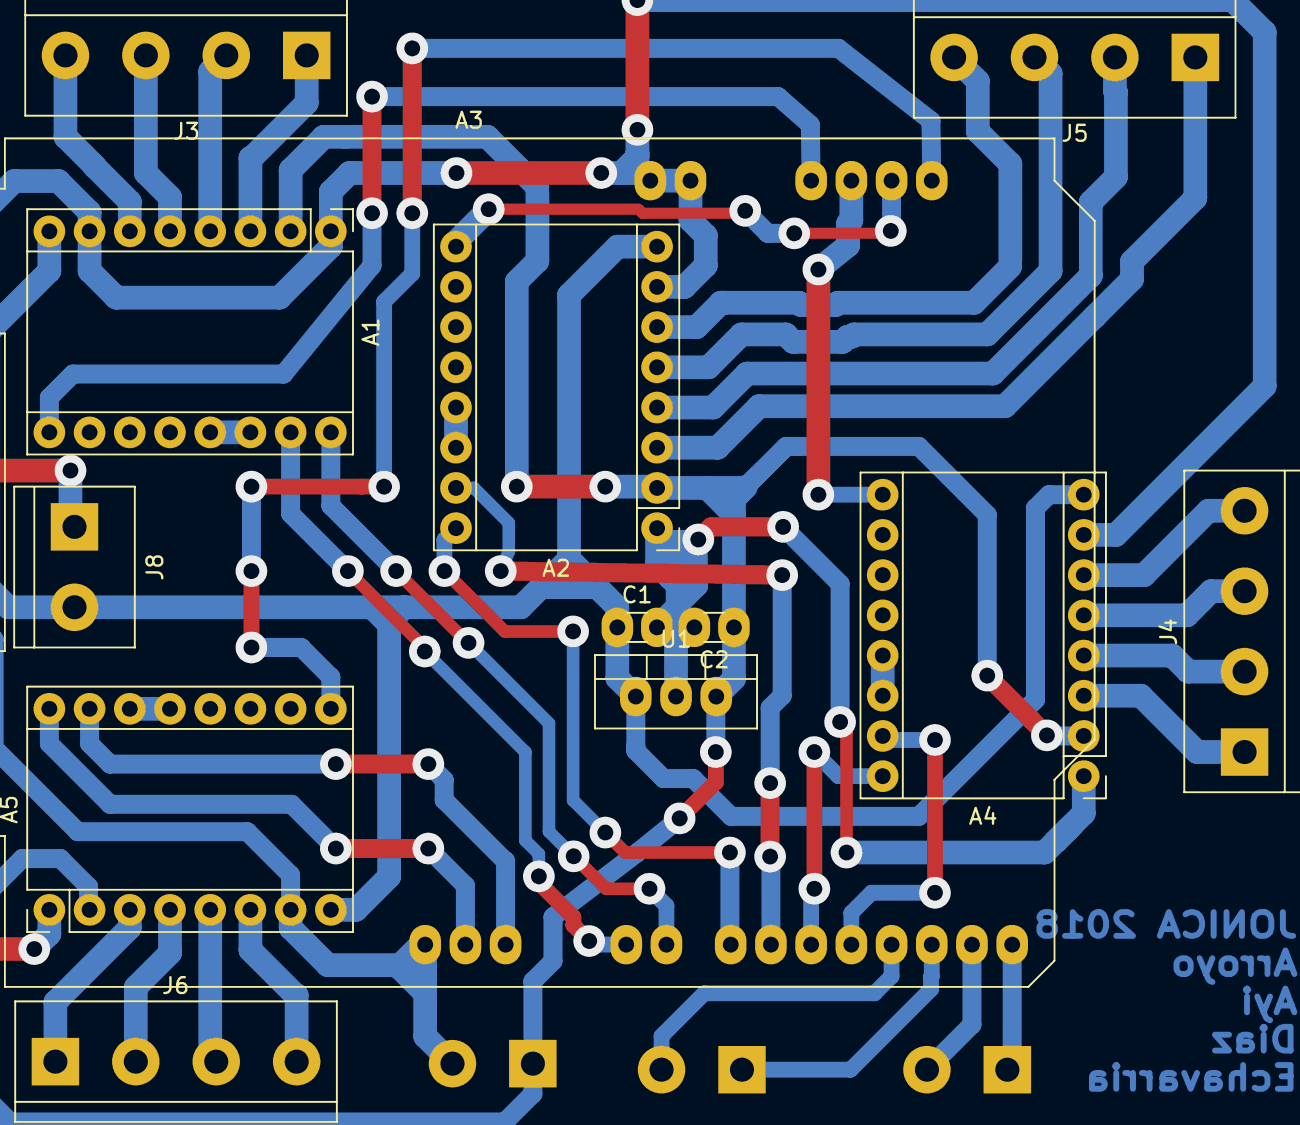
[picture p59: board Circuito/Shield/JONICA.kicad_pcb from above]

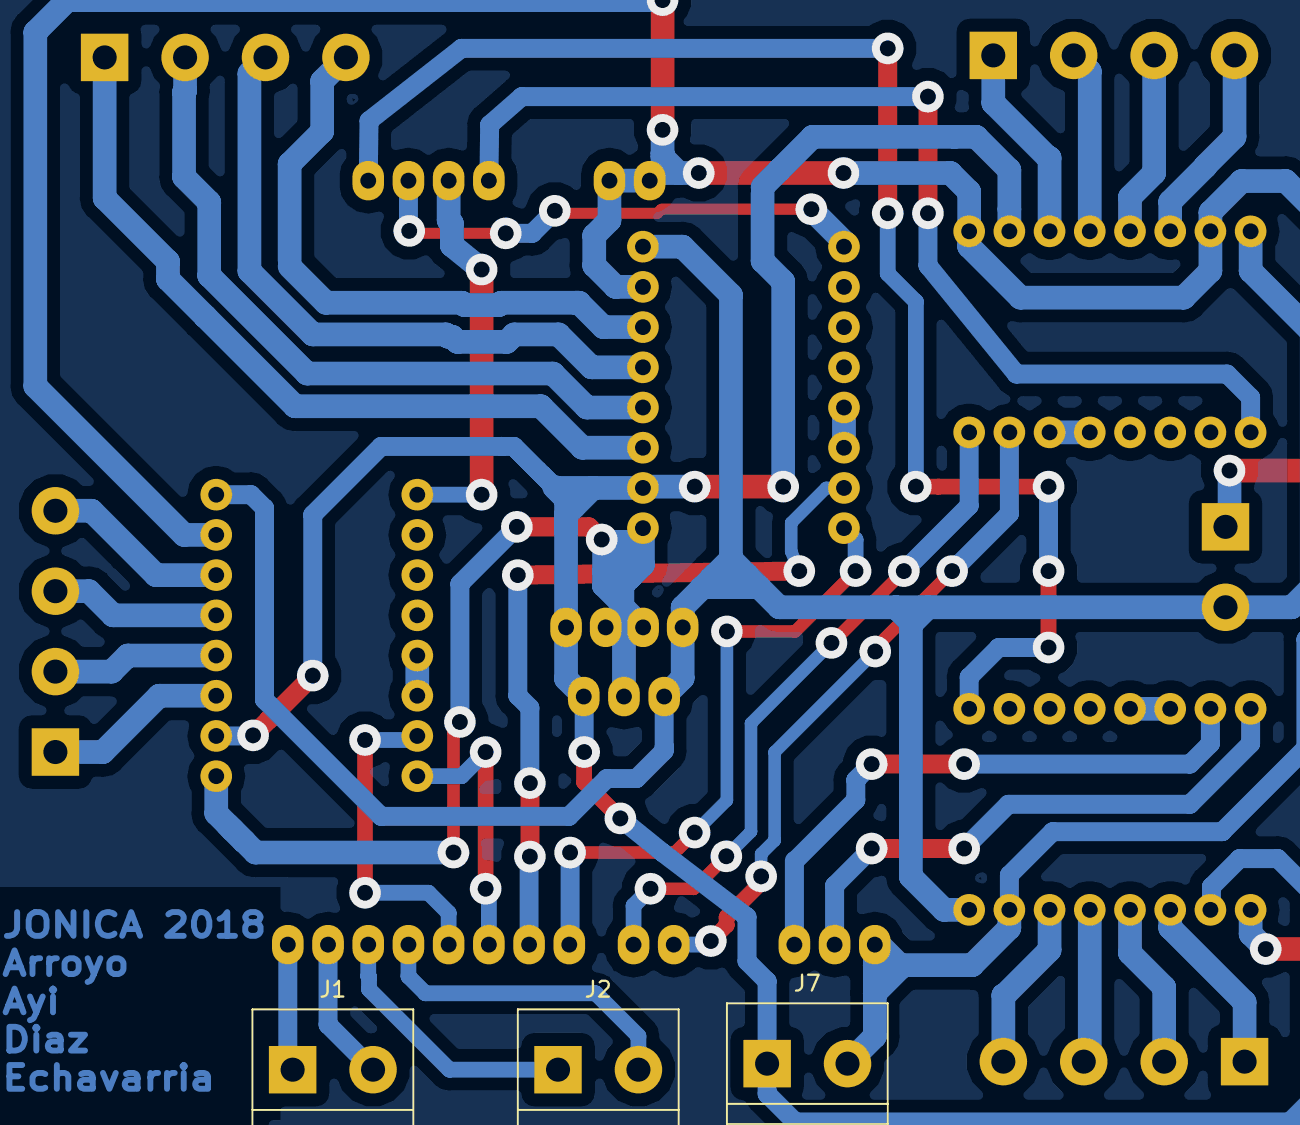
[picture p60: board Circuito/Shield/JONICA.kicad_pcb from below]

Board: 2 copper layers, 16 parts (3 on the bottom side), 39 nets.

Parts:
A1, A2, A4, A5: Pololu_Breakout_A4988; Pololu_Breakout-16_15.2x20.3mm
A3: Arduino_UNO_R3
C1: 330nF; C_Disc_D3.0mm_W1.6mm_P2.50mm
C2: 100nF; C_Disc_D3.0mm_W1.6mm_P2.50mm
J1: UART; TerminalBlock_bornier-2_P5.08mm
J2: SENSORES; TerminalBlock_bornier-2_P5.08mm
J3: M1; TerminalBlock_bornier-4_P5.08mm
J4: M2; TerminalBlock_bornier-4_P5.08mm
J5: M3; TerminalBlock_bornier-4_P5.08mm
J6: M0-POLOLU; TerminalBlock_bornier-4_P5.08mm
J7: ALIM_SENSORES; TerminalBlock_bornier-2_P5.08mm
J8: ALIMENTACION; TerminalBlock_bornier-2_P5.08mm
U1: L7805; TO-220-3_Vertical

Connections:
+5V: A1.2, A2.2, A4.2, A5.2, C2.1, J7.1, U1.3
+12V: A1.8, A2.8, A4.8, A5.8, C1.1, J8.2, U1.1
/ENA0-POLOLU: A3.12, A5.9
/ENA1: A1.9, A3.9
/ENA2: A3.10, A4.9
/ENA3: A2.9, A3.11
/M0_1A: A5.3, J6.1
/M0_1B: A5.4, J6.2
/M0_2A: A5.5, J6.3
/M0_2B: A5.6, J6.4
/M0_DIR: A3.28, A5.16
/M0_STEP: A3.27, A5.15
/M1_1A: A1.3, J3.1
/M1_1B: A1.4, J3.2
/M1_2A: A1.5, J3.3
/M1_2B: A1.6, J3.4
/M1_DIR: A1.16, A3.23
/M1_STEP: A1.15, A3.24
/M2_1A: A4.3, J4.1
/M2_1B: A4.4, J4.2
/M2_2A: A4.5, J4.3
/M2_2B: A4.6, J4.4
/M2_DIR: A3.20, A4.16
/M2_STEP: A3.19, A4.15
/M3_1A: A2.3, J5.1
/M3_1B: A2.4, J5.2
/M3_2A: A2.5, J5.3
/M3_2B: A2.6, J5.4
/M3_DIR: A2.16, A3.22
/M3_STEP: A2.15, A3.21
/RX: A3.15, J1.1
/SENSOR1: A3.17, J2.1
/SENSOR2: A3.18, J2.2
/TX: A3.16, J1.2
GND: A1.1, A1.7, A2.1, A2.7, A3.6, A3.7, A3.29, A4.1, A4.7, A5.1, A5.7, C1.2, C2.2, J7.2, J8.1, U1.2
unnamed: A1.13, A1.14
unnamed: A2.13, A2.14
unnamed: A4.13, A4.14
unnamed: A5.13, A5.14
