mhechavarria/color-caps-classifier/Circuito/Circuito v1/JONICA.kicad_pcb

## KiCad design Circuito/Circuito v1/JONICA.kicad_pcb (2019-12-16, an earlier design)

Schematic: JONICA.sch

Parts:
A1, A2, A4, A5: Pololu_Breakout_A4988; Pololu_Breakout-16_15.2x20.3mm
A3: Arduino_UNO_R3
C1: 330nF; C_Disc_D3.0mm_W1.6mm_P2.50mm
C2: 100nF; C_Disc_D3.0mm_W1.6mm_P2.50mm
J1: SENSOR3; TerminalBlock_bornier-3_P5.08mm
J2: M0-MOSFET; TerminalBlock_bornier-4_P5.08mm
J3: UART; TerminalBlock_bornier-2_P5.08mm
J4: M1; TerminalBlock_bornier-4_P5.08mm
J5: M2; TerminalBlock_bornier-4_P5.08mm
J6: M3; TerminalBlock_bornier-4_P5.08mm
J7: M0-POLOLU; TerminalBlock_bornier-4_P5.08mm
J8: SENSOR2; TerminalBlock_bornier-3_P5.08mm
J9: SENSOR1; TerminalBlock_bornier-3_P5.08mm
Q1, Q2, Q3, Q4: IRLZ44N; TO-220-3_Vertical
R1, R16, R18, R20, R21, R22, R23: 10k; R_Axial_DIN0207_L6.3mm_D2.5mm_P10.16mm_Horizontal
R2, R3, R4: 220; R_Axial_DIN0207_L6.3mm_D2.5mm_P10.16mm_Horizontal
R5, R6, R7: 39k; R_Axial_DIN0207_L6.3mm_D2.5mm_P10.16mm_Horizontal
R8, R9, R10: 1k6; R_Axial_DIN0207_L6.3mm_D2.5mm_P10.16mm_Horizontal
R11, R13, R24, R26: 1k5; R_Axial_DIN0207_L6.3mm_D2.5mm_P10.16mm_Horizontal
R12, R14, R25: 4k7; R_Axial_DIN0207_L6.3mm_D2.5mm_P10.16mm_Horizontal
R15, R17, R19: 47k; R_Axial_DIN0207_L6.3mm_D2.5mm_P10.16mm_Horizontal
R27: 4k7; R_Axial_DIN0309_L9.0mm_D3.2mm_P20.32mm_Horizontal
R28, R29, R30, R31: 3.9; R_Axial_DIN0309_L9.0mm_D3.2mm_P20.32mm_Horizontal
U1: LM358; DIP-8_W7.62mm_LongPads
U2: L7805; TO-220-3_Vertical
U3: LM324; DIP-14_W7.62mm_LongPads
U4: 74LS08; DIP-14_W7.62mm_LongPads
U5: ULN2003A; DIP-16_W7.62mm_LongPads
U6, U7, U8: CNY70

Connections:
+5V: A1.2, A2.2, A4.2, A5.2, C2.1, J1.1, J8.1, J9.1, R2.2, R3.2, R4.2, R15.2, R17.2, R19.2, U1.8 (V+), U2.3, U3.4 (V+), U4.14, U6.3, U7.3, U8.3
+12V: A1.8, A2.8, A4.8, A5.8, C1.1, R11.1, R13.1, R24.1, R26.1, U2.1
/ENA0-GATES: A3.12, R1.1, U4.2, U4.5, U4.10, U4.13
/ENA0-POLOLU: A3.13, A5.9
/ENA1: A1.9, A3.9
/ENA2: A3.10, A4.9
/ENA3: A2.9, A3.11
/M0_1A: A5.3, J7.1
/M0_1B: A5.4, J7.2
/M0_2A: A5.5, J7.3
/M0_2B: A5.6, J7.4
/M0_DIR: A3.28, A5.16
/M0_STEP: A3.27, A5.15
/M1_1A: A1.3, J4.1
/M1_1B: A1.4, J4.2
/M1_2A: A1.5, J4.3
/M1_2B: A1.6, J4.4
/M1_DIR: A1.16, A3.18
/M1_STEP: A1.15, A3.17
/M2_1A: A4.3, J5.1
/M2_1B: A4.4, J5.2
/M2_2A: A4.5, J5.3
/M2_2B: A4.6, J5.4
/M2_DIR: A3.20, A4.16
/M2_STEP: A3.19, A4.15
/M3_1A: A2.3, J6.1
/M3_1B: A2.4, J6.2
/M3_2A: A2.5, J6.3
/M3_2B: A2.6, J6.4
/M3_DIR: A2.16, A3.22
/M3_STEP: A2.15, A3.21
/RX: A3.15, J3.1
/TX: A3.16, J3.2
GND: A1.1, A1.7, A2.1, A2.7, A3.6, A3.7, A3.29, A4.1, A4.7, A5.1, A5.7, C1.2, C2.2, J1.3, J8.3, J9.3, Q1.3 (S), Q2.3 (S), Q3.3 (S), Q4.3 (S), R1.2, R5.2, R6.2, R7.2, R12.2, R14.2, R16.1, R18.1, R20.1, R25.2, R27.2, U1.4 (V-), U2.2, U3.11 (V-), U4.7, U5.8 (GND), U6.2, U7.2, U8.2
unnamed: A1.13, A1.14
unnamed: A2.13, A2.14
unnamed: A3.23, U4.1
unnamed: A3.24, U4.4
unnamed: A3.25, U4.9
unnamed: A3.26, U4.12
unnamed: A4.13, A4.14
unnamed: A5.13, A5.14
unnamed: J1.2, R23.1, U3.14
unnamed: J2.1, R30.1
unnamed: J2.2, R28.1
unnamed: J2.3, R29.1
unnamed: J2.4, R31.1
unnamed: J8.2, R22.1, U3.7
unnamed: J9.2, R21.1, U1.7
unnamed: Q1.1 (G), R11.2, R12.1, U5.16 (O1)
unnamed: Q1.2 (D), R30.2
unnamed: Q2.1 (G), R13.2, R14.1, U5.14 (O3)
unnamed: Q2.2 (D), R29.2
unnamed: Q3.1 (G), R24.2, R25.1, U5.15 (O2)
unnamed: Q3.2 (D), R28.2
unnamed: Q4.1 (G), R26.2, R27.1, U5.13 (O4)
unnamed: Q4.2 (D), R31.2
unnamed: R2.1, U6.1
unnamed: R3.1, U7.1
unnamed: R4.1, U8.1
unnamed: R5.1, U1.3 (+), U6.4
unnamed: R6.1, U3.3 (+), U7.4
unnamed: R7.1, U3.10 (+), U8.4
unnamed: R8.2, U1.1, U1.2 (-)
unnamed: R9.2, U3.1, U3.2 (-)
unnamed: R10.1, R23.2, U3.12 (+)
unnamed: R10.2, U3.8, U3.9 (-)
unnamed: R15.1, R16.2, U1.6 (-)
unnamed: R17.1, R18.2, U3.6 (-)
unnamed: R19.1, R20.2, U3.13 (-)
unnamed: R8.1, R21.2, U1.5 (+)
unnamed: R9.1, R22.2, U3.5 (+)
unnamed: U4.3, U5.1 (I1)
unnamed: U4.6, U5.2 (I2)
unnamed: U4.8, U5.3 (I3)
unnamed: U4.11, U5.4 (I4)

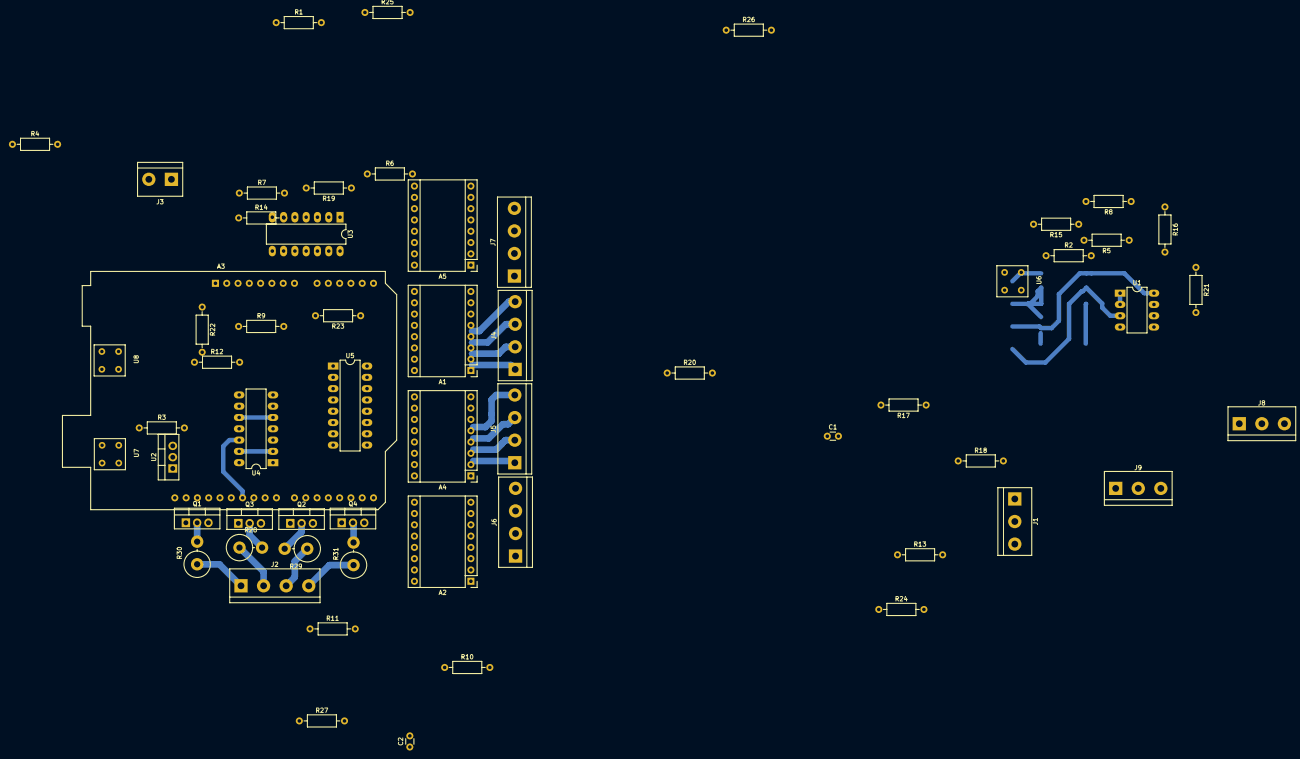
[picture p61: board Circuito/Circuito v1/JONICA.kicad_pcb from above]

Board: 2 copper layers, 59 parts (0 on the bottom side), 76 nets.
