mhechavarria/color-caps-classifier/Sensor IR/Sensor IR.brd

## EAGLE design Sensor IR/Sensor IR.brd (2019-12-16)

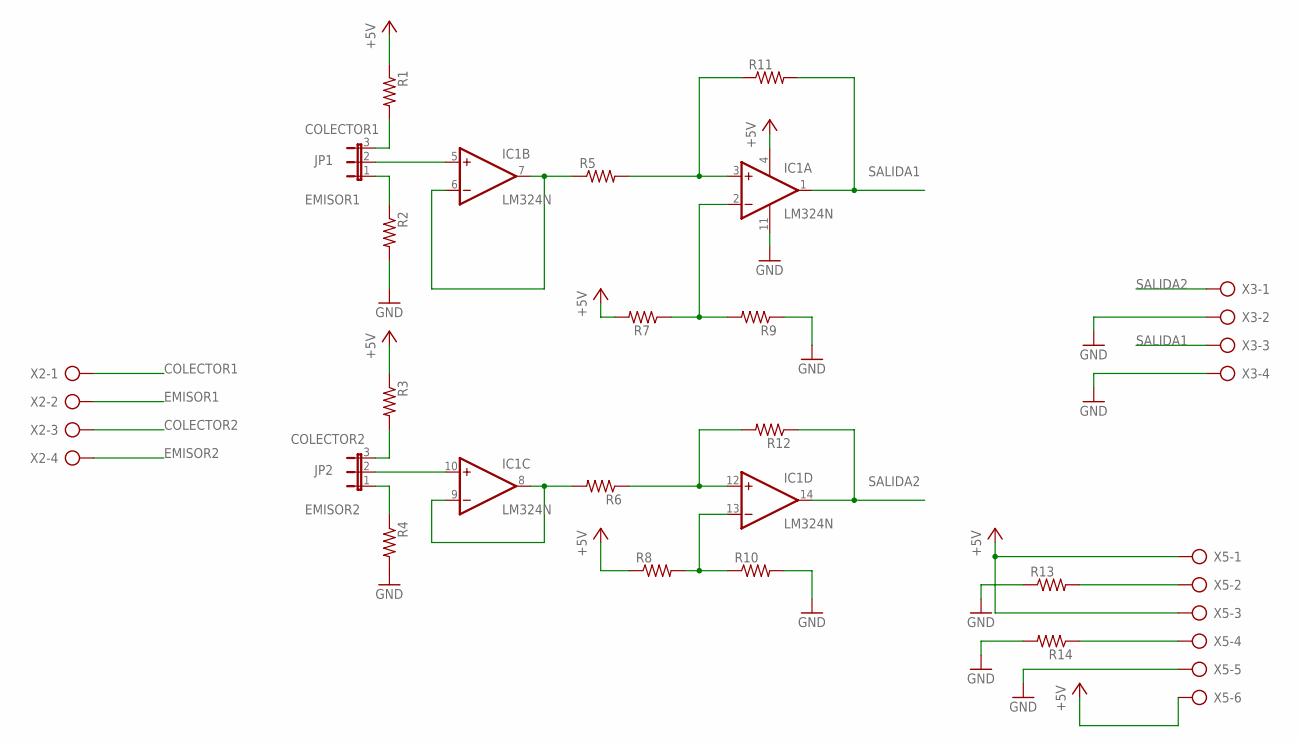
[picture p62: schematic Sensor IR.sch]

Parts:
IC1: LM324N; DIL14
JP1, JP2: JP2E; JP2
R1, R2, R3, R4, R5, R6, R7, R8, R9, R10, R11, R12, R13, R14: R-US_0207/10; 0207/10
X2, X3: AK500/4-H
X5: AK500/6-H

Connections:
+5V: IC1.4 (V+), R1.1, R3.1, R7.2, R8.1, X5.1, X5.3, X5.6
COLECTOR1: JP1.3, R1.2, X2.1
COLECTOR2: JP2.3, R3.2, X2.3
EMISOR1: JP1.1, R2.1, X2.2
EMISOR2: JP2.1, R4.1, X2.4
GND: IC1.11 (V-), R2.2, R4.2, R9.1, R10.2, R13.1, R14.2, X3.2, X3.4, X5.5
unnamed: IC1.6 (-IN), IC1.7 (OUT), R5.1
unnamed: IC1.8 (OUT), IC1.9 (-IN), R6.2
unnamed: IC1.3 (+IN), R5.2, R11.1
unnamed: R14.1, X5.4
unnamed: R13.2, X5.2
unnamed: IC1.5 (+IN), JP1.2
unnamed: IC1.13 (-IN), R8.2, R10.1
unnamed: IC1.12 (+IN), R6.1, R12.2
unnamed: IC1.2 (-IN), R7.1, R9.2
unnamed: IC1.10 (+IN), JP2.2
SALIDA1: IC1.1 (OUT), R11.2, X3.3
SALIDA2: IC1.14 (OUT), R12.1, X3.1

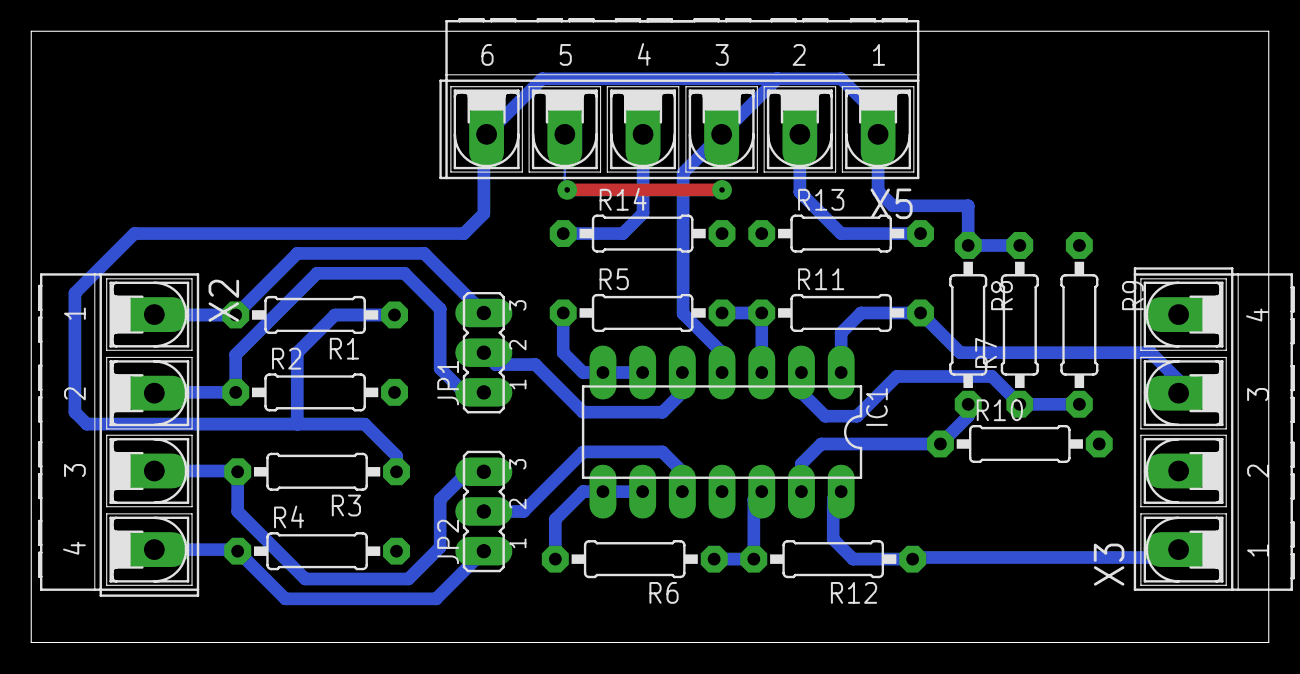
[picture p63: board Sensor IR.brd from above]

Board: 2 copper layers, 79.2 x 39.1 mm, 20 parts (0 on the bottom side), 18 nets.
