mhechavarria/color-caps-classifier/Shield pololu/Shield pololu.brd

## EAGLE design Shield pololu/Shield pololu.brd (2019-12-16)

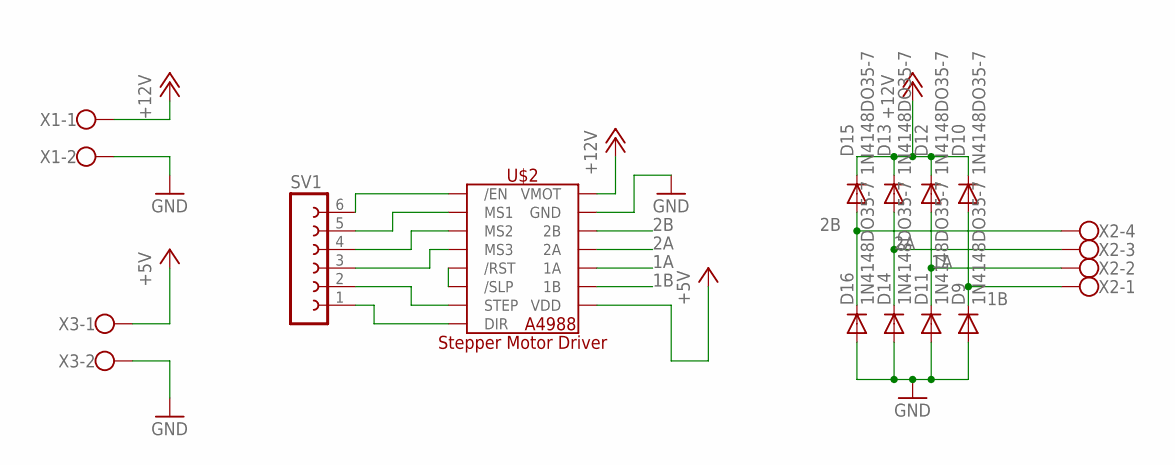
[picture p64: schematic Shield pololu.sch]

Parts:
D9, D10, D11, D12, D13, D14, D15, D16: 1N4148DO35-7; DO35-7
SV1: FE06-1; FE06
U$2: A4988_STEP
X1, X3: W237-102
X2: W237-4

Connections:
1A: D11.C, D12.A, U$2.1A, X2.2
1B: D9.C, D10.A, U$2.1B, X2.1
2A: D13.A, D14.C, U$2.2A, X2.3
2B: D15.A, D16.C, U$2.2B, X2.4
+5V: U$2.VDD, X3.1
+12V: D10.C, D12.C, D13.C, D15.C, U$2.VMOT, X1.1
GND: D9.A, D11.A, D14.A, D16.A, U$2.GND, U$2.GND2 (GND), X1.2, X3.2
unnamed: SV1.6, U$2./EN
unnamed: SV1.5, U$2.MS1
unnamed: SV1.4, U$2.MS2
unnamed: SV1.3, U$2.MS3
unnamed: SV1.2, U$2.STEP
unnamed: SV1.1, U$2.DIR
unnamed: U$2./RST, U$2./SLP

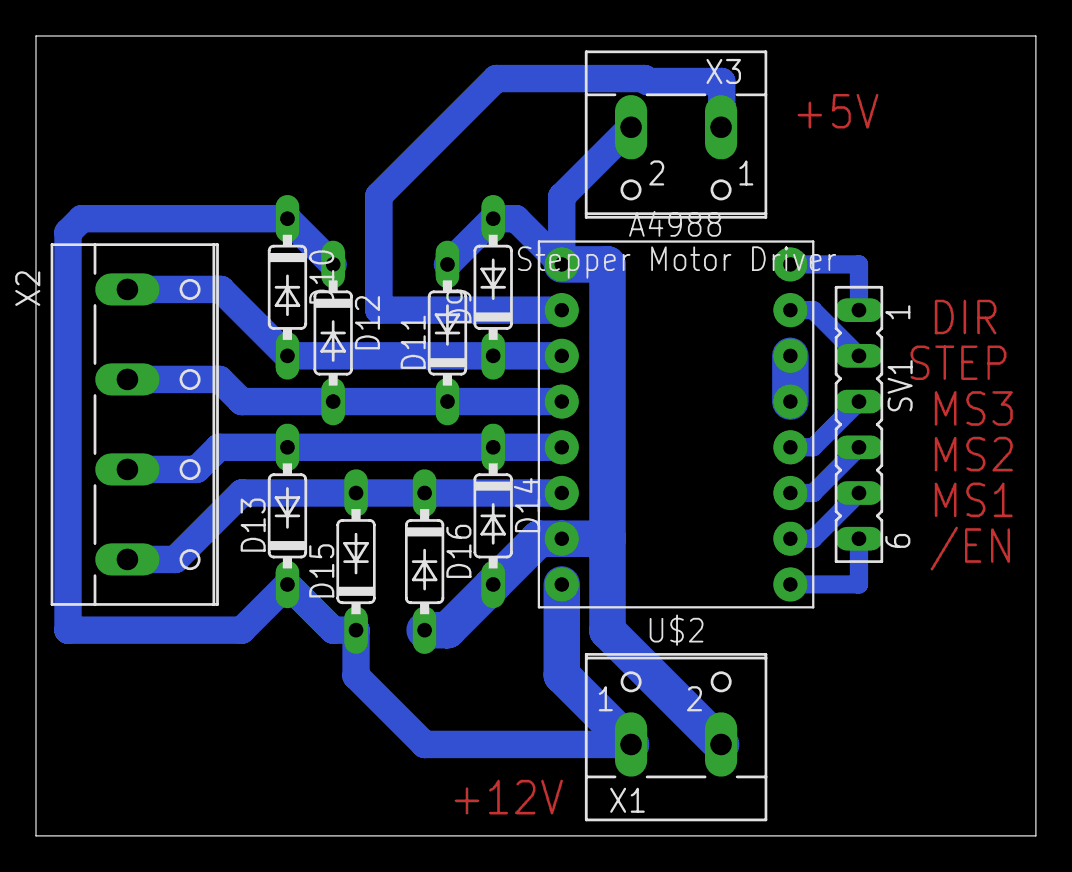
[picture p65: board Shield pololu.brd from above]

Board: 2 copper layers, 55.5 x 44.4 mm, 13 parts (0 on the bottom side), 14 nets.
