mhechavarria/color-caps-classifier/Motor_paso_a_paso.ino/Prueba_a4988/Prueba_a4988.ino

const int stepPin = 7; 
const int dirPin = 2; 
#define espera 80
#define arranque1 7500
#define arranque2 6500
#define arranque3 5500
#define corto 4500
void setup() {
  // Sets the two pins as Outputs
  pinMode(stepPin,OUTPUT); 
  pinMode(dirPin,OUTPUT);
  pinMode(LED_BUILTIN, OUTPUT);
}
void loop() {
  digitalWrite(LED_BUILTIN, !digitalRead(LED_BUILTIN));
  digitalWrite(dirPin,HIGH); // Enables the motor to move in a particular direction
  // Makes 200 pulses for making one full cycle rotation
  for(int x = 0; x < 3; x++) {
    digitalWrite(stepPin,HIGH); 
    delayMicroseconds(500); 
    digitalWrite(stepPin,LOW); 
    delayMicroseconds(arranque1); 
  }
    for(int x = 0; x < 3; x++) {
    digitalWrite(stepPin,HIGH); 
    delayMicroseconds(500); 
    digitalWrite(stepPin,LOW); 
    delayMicroseconds(arranque2); 
  }
    for(int x = 0; x < 3; x++) {
    digitalWrite(stepPin,HIGH); 
    delayMicroseconds(500); 
    digitalWrite(stepPin,LOW); 
    delayMicroseconds(arranque3); 
  }
    for(int x = 0; x < 15; x++) {
    digitalWrite(stepPin,HIGH); 
    delayMicroseconds(500); 
    digitalWrite(stepPin,LOW); 
    delayMicroseconds(corto); 
    
  }
    digitalWrite(dirPin,LOW); // Enables the motor to move in a particular direction
  delay(200);
  for(int x = 0; x < 4; x++) {
    digitalWrite(stepPin,HIGH); 
    delayMicroseconds(500); 
    digitalWrite(stepPin,LOW); 
    delayMicroseconds(arranque3); 
  }
  for(int x = 0; x < 2; x++) {
    digitalWrite(stepPin,HIGH); 
    delayMicroseconds(500); 
    digitalWrite(stepPin,LOW); 
    delayMicroseconds(arranque2); 
  }
  for(int x = 0; x < 2; x++) {
    digitalWrite(stepPin,HIGH); 
    delayMicroseconds(500); 
    digitalWrite(stepPin,LOW); 
    delayMicroseconds(arranque1); 
  }
  delay(espera);
}
